Arkos-Engineering/HT-15/hardware/Battery/Radio Interface/Radio Interface.step

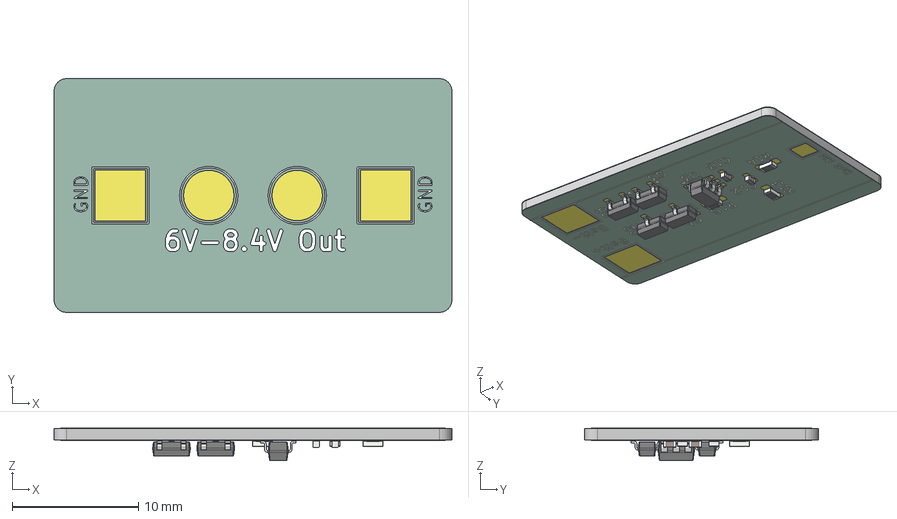
[picture p1: CAD file, 2025-10-05]
hardware/Battery/Radio Interface/Radio Interface.step
31.5 x 18.5 x 2.62 mm
SOT-23-6
R_0603_1608Metric x 3
C_0402_1005Metric x 2
SOT-23 x 4
Radio Interface_copper
Radio Interface_silkscreen
Radio Interface_soldermask
Radio Interface_PCB
