Arkos-Engineering/HT-15/hardware/Implementation/ELECTRICAL SCHEME RT90 & MD9600.pdf

# FM AF PROCESS CIRCUIT

2

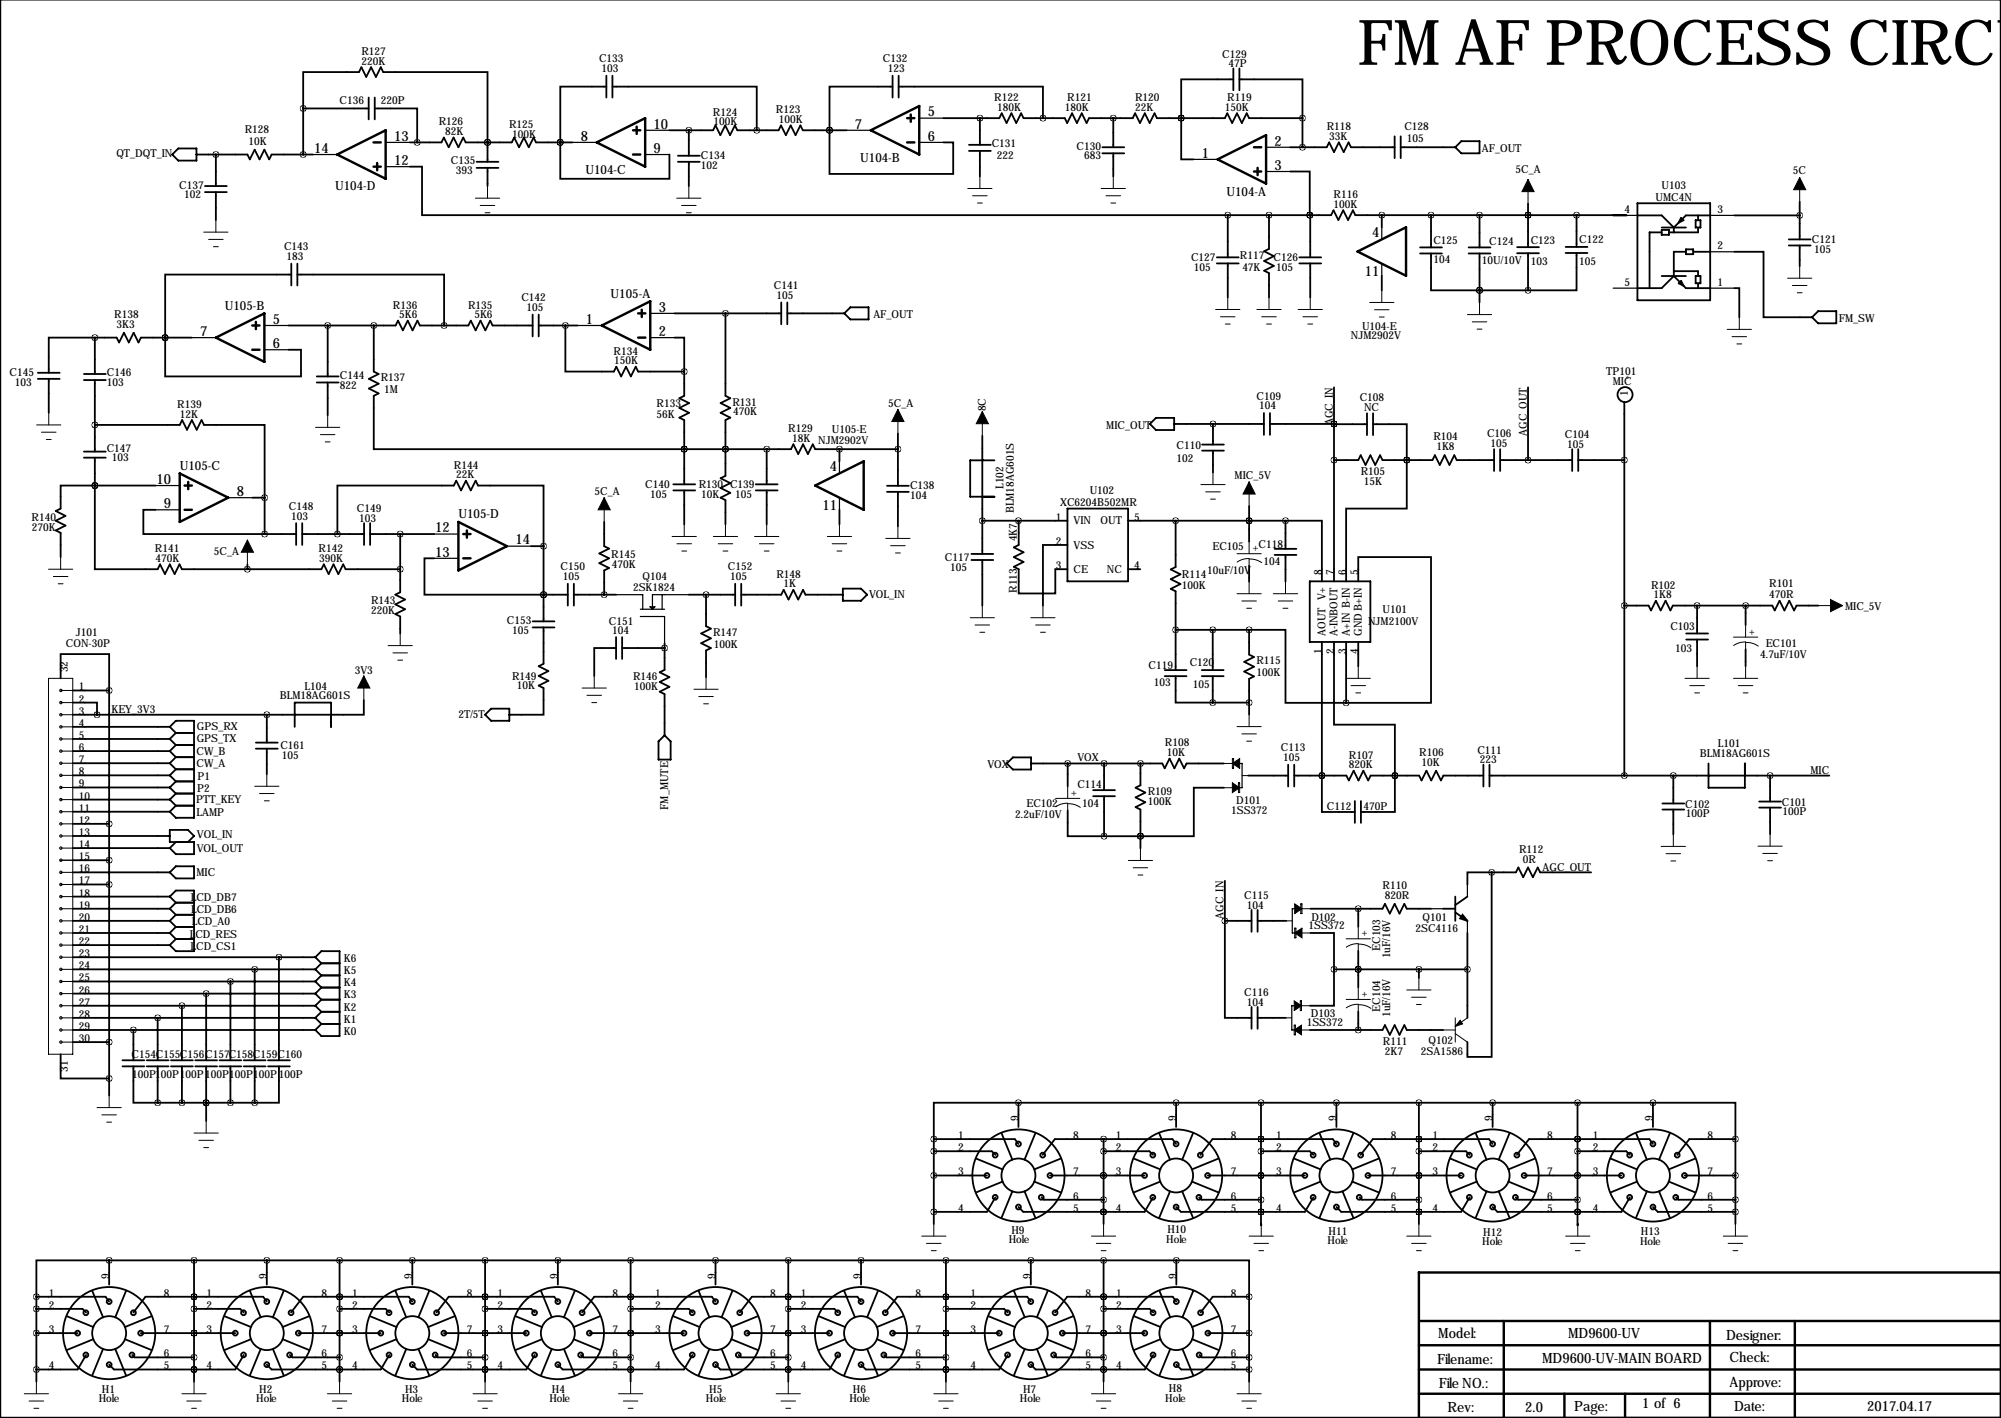
[picture p2: page 1]

Model: | MD9600-UV | Designer:

Filename: | MD9600-UV-MAIN BOARD | Check:

File NO.: | | Approve:
Rev: | 2.0 | Page: | of | Date: | 2017.04.17

# BASEBAND&AF AMP

0603

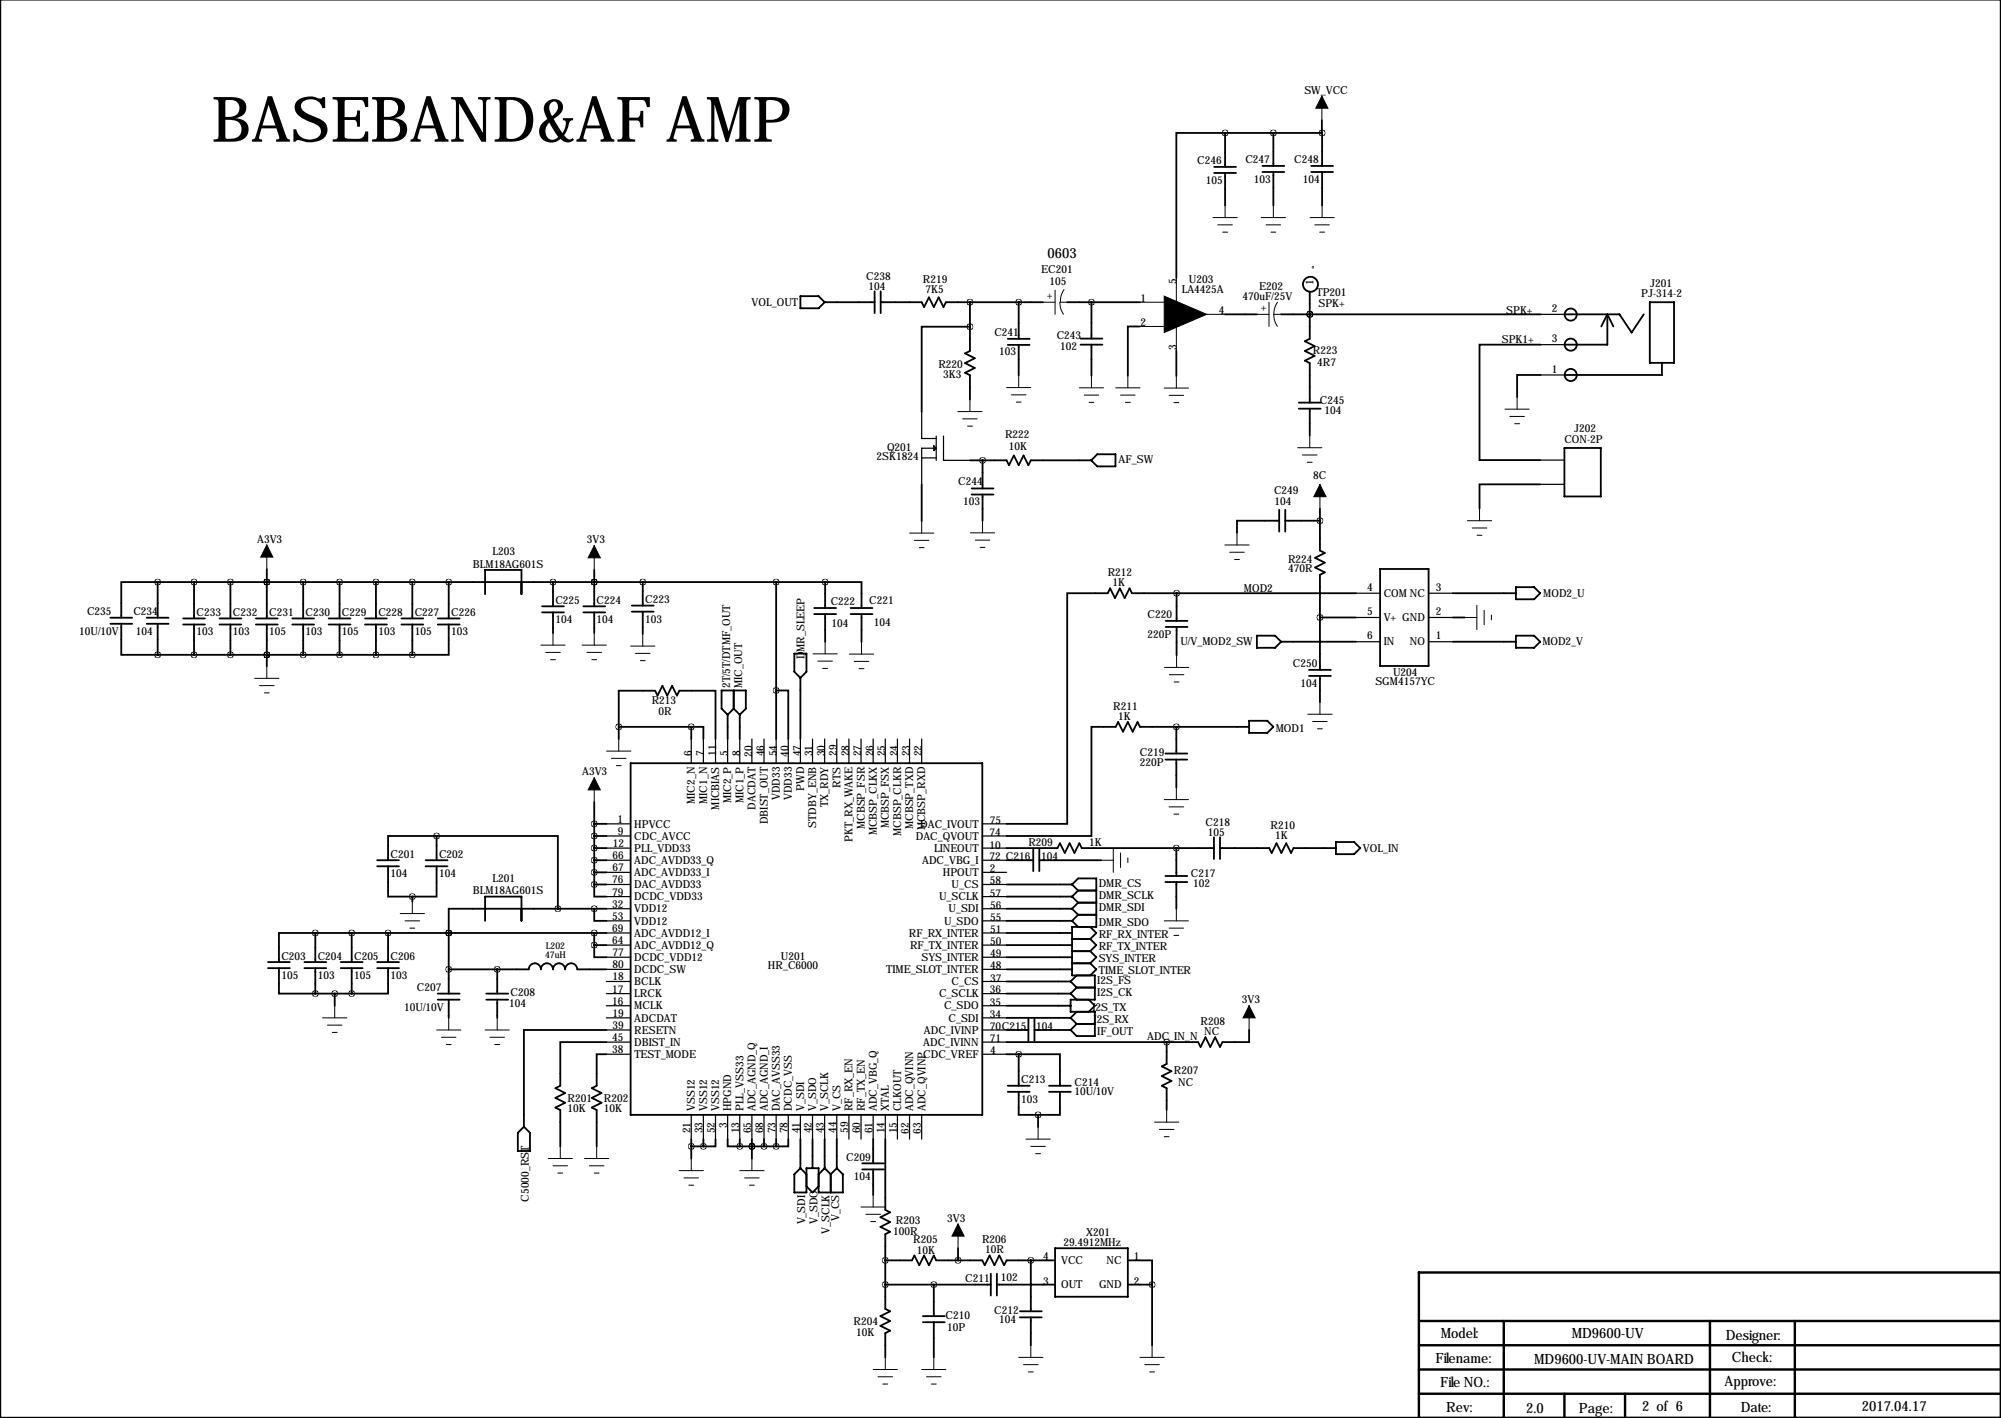
[picture p3: page 2]

# MCU

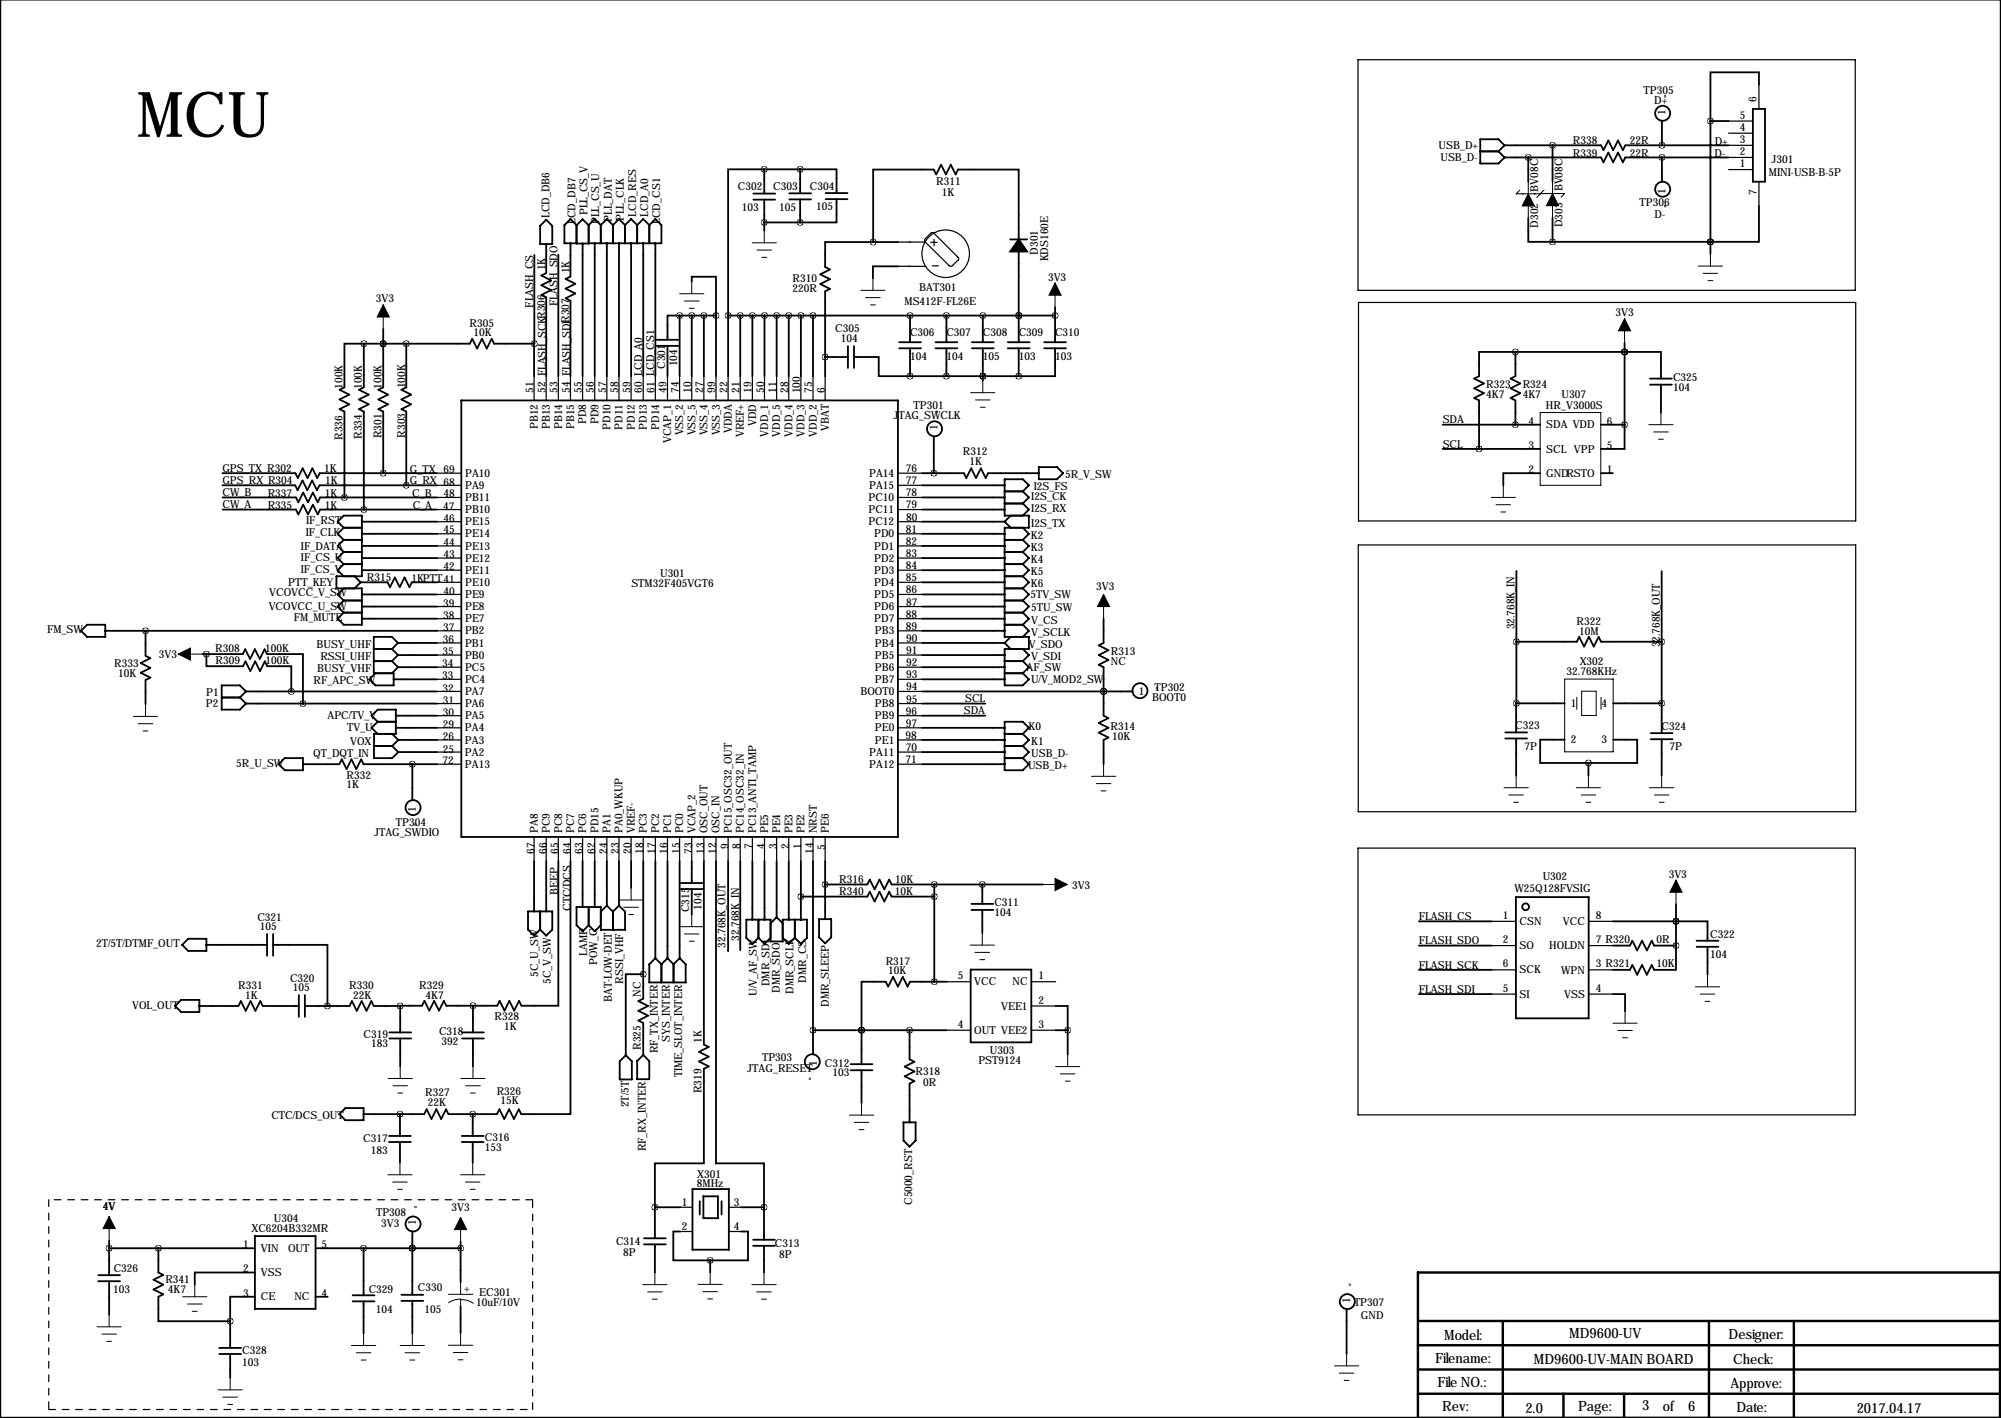
[picture p4: page 3]

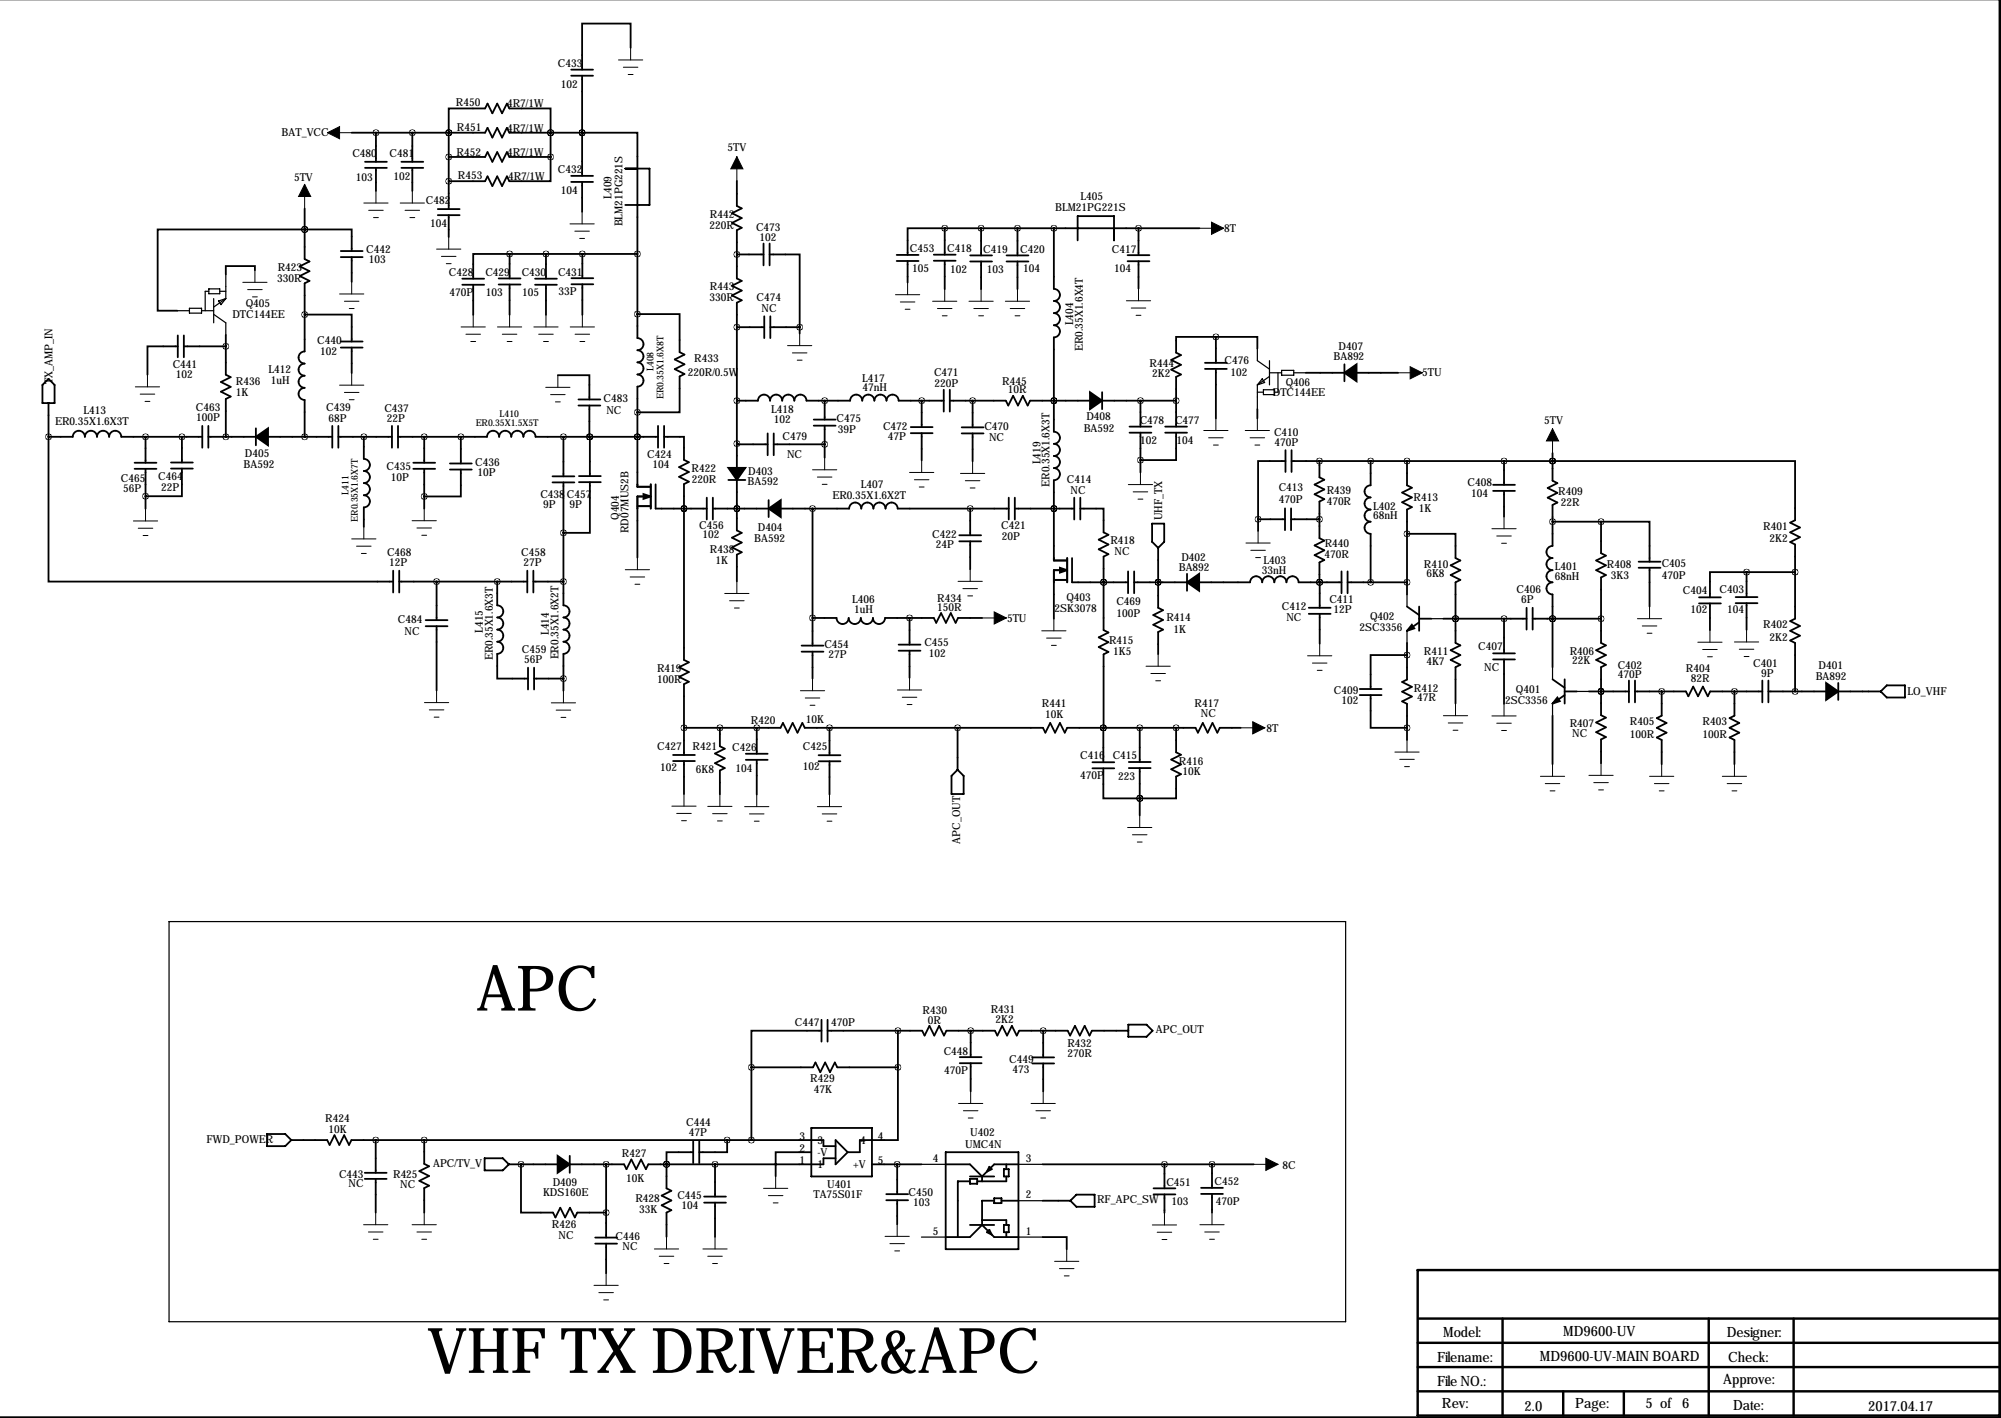
[picture p5: page 4]

0.5W

C560

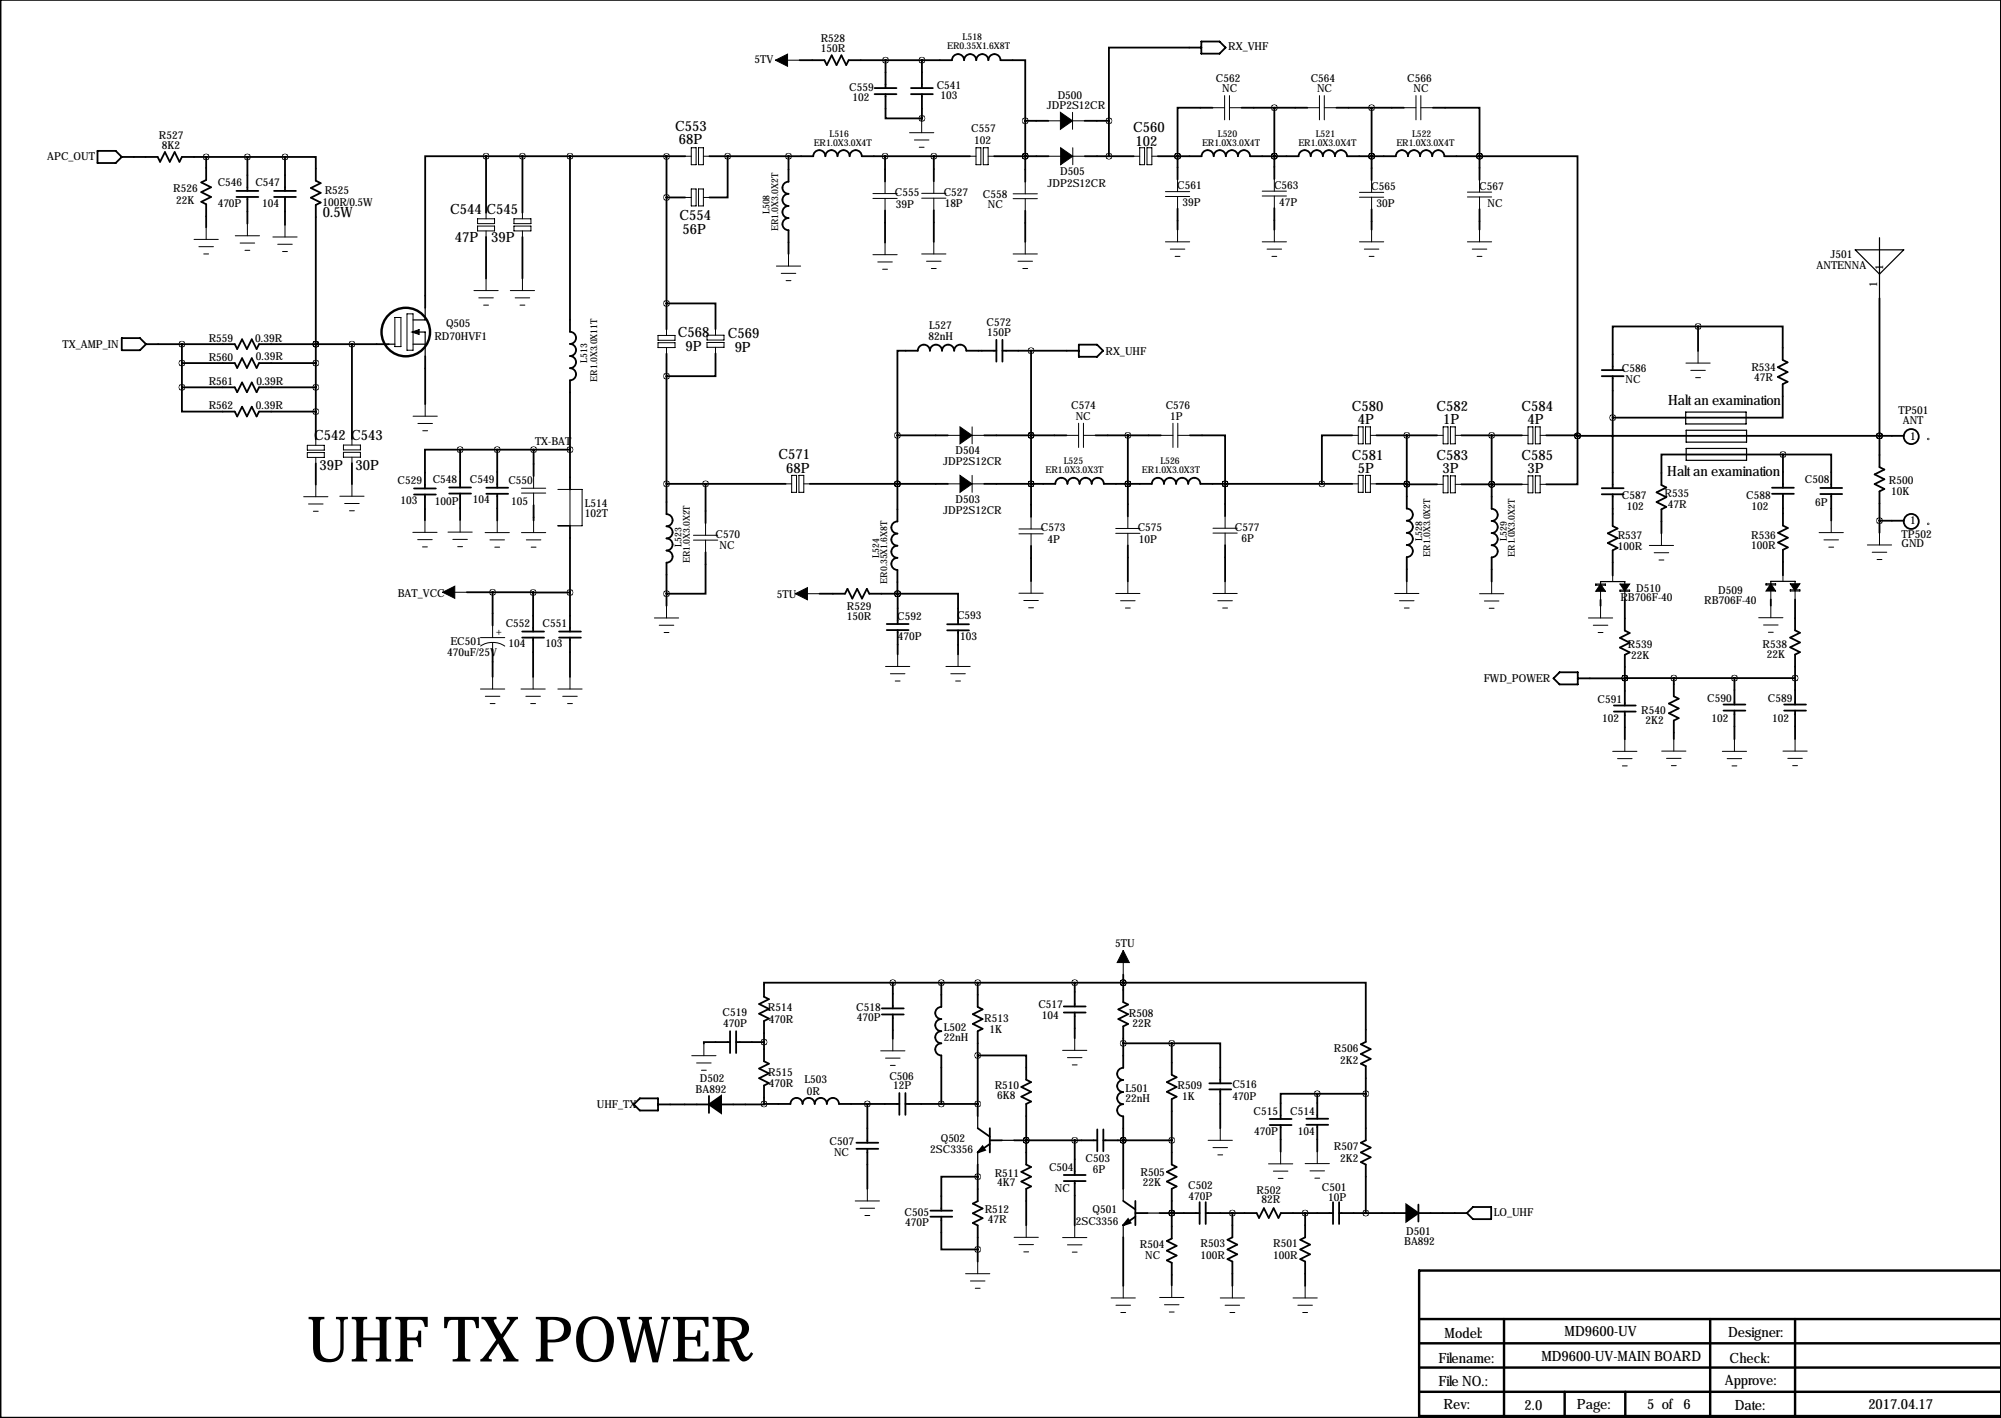
[picture p6: page 5]

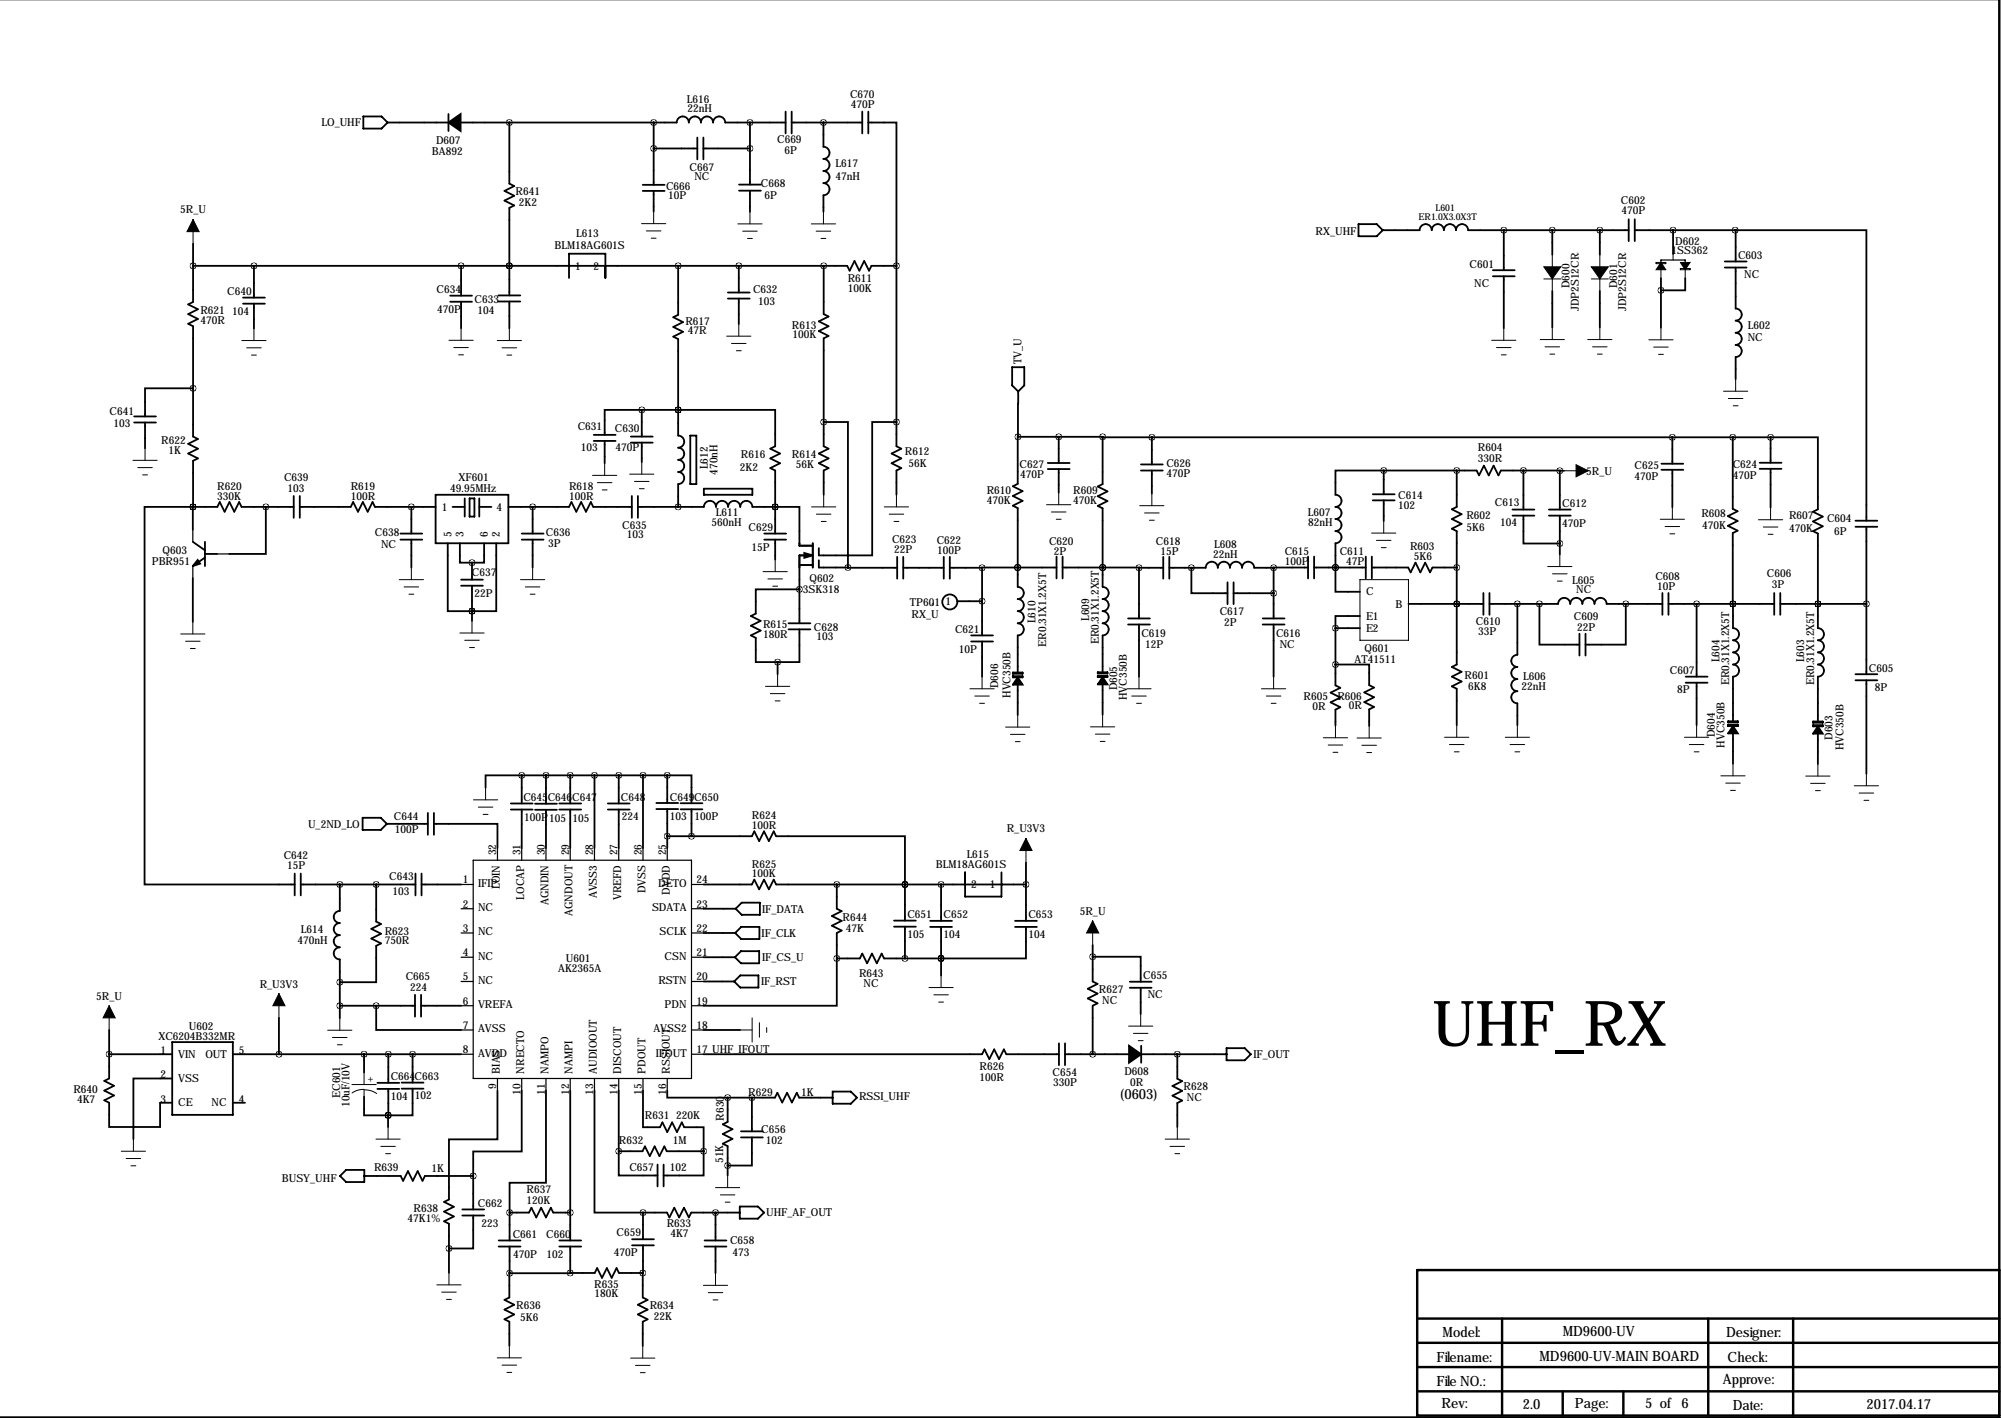
[picture p7: page 6]

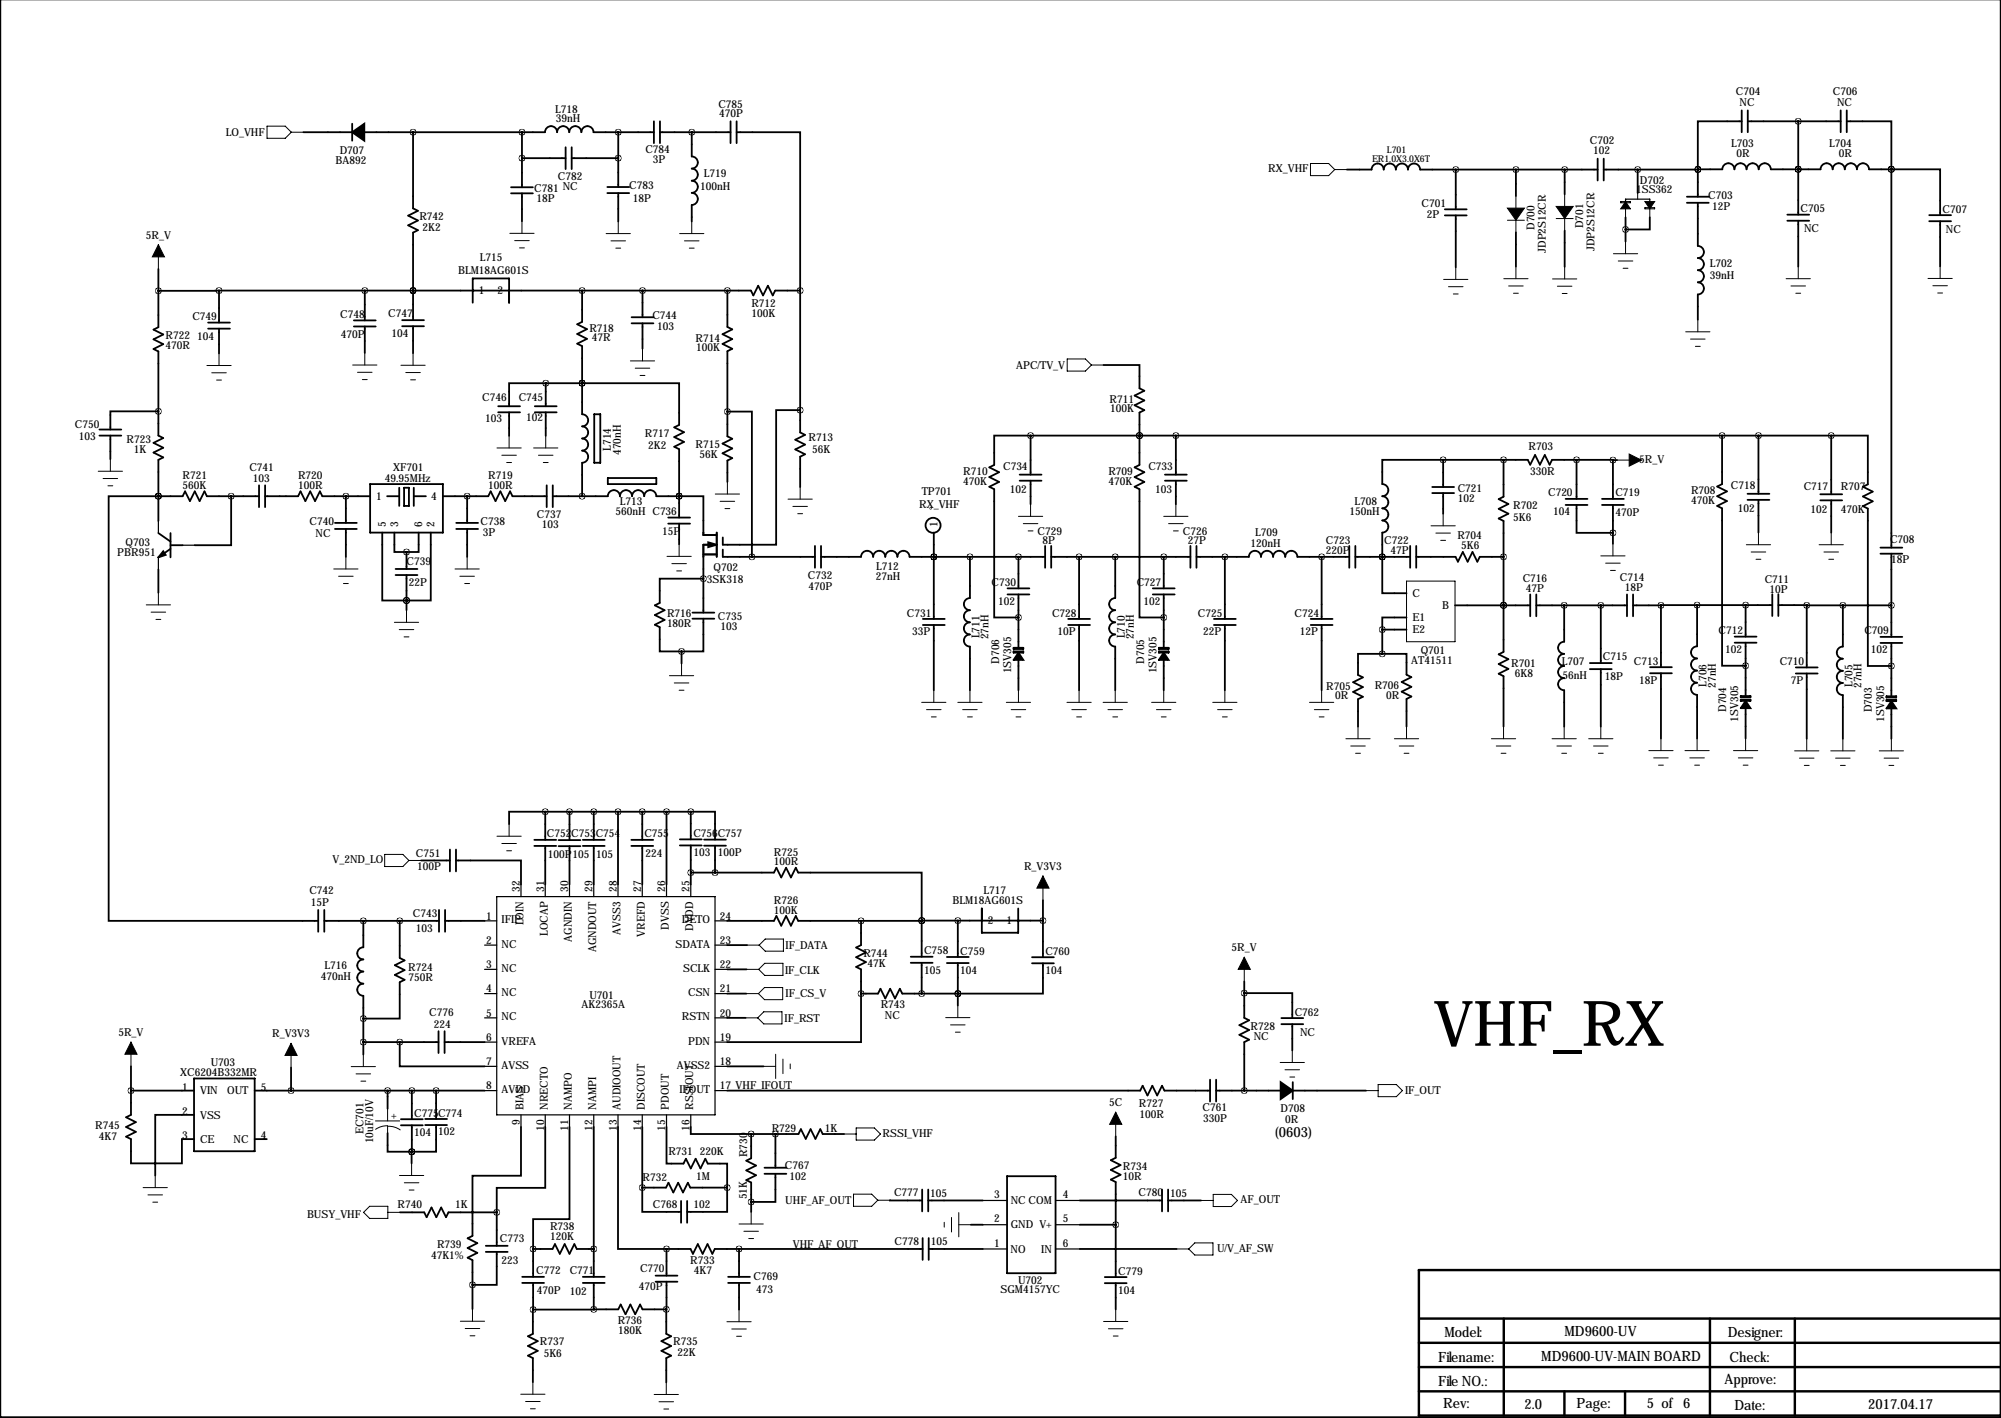
[picture p8: page 7]

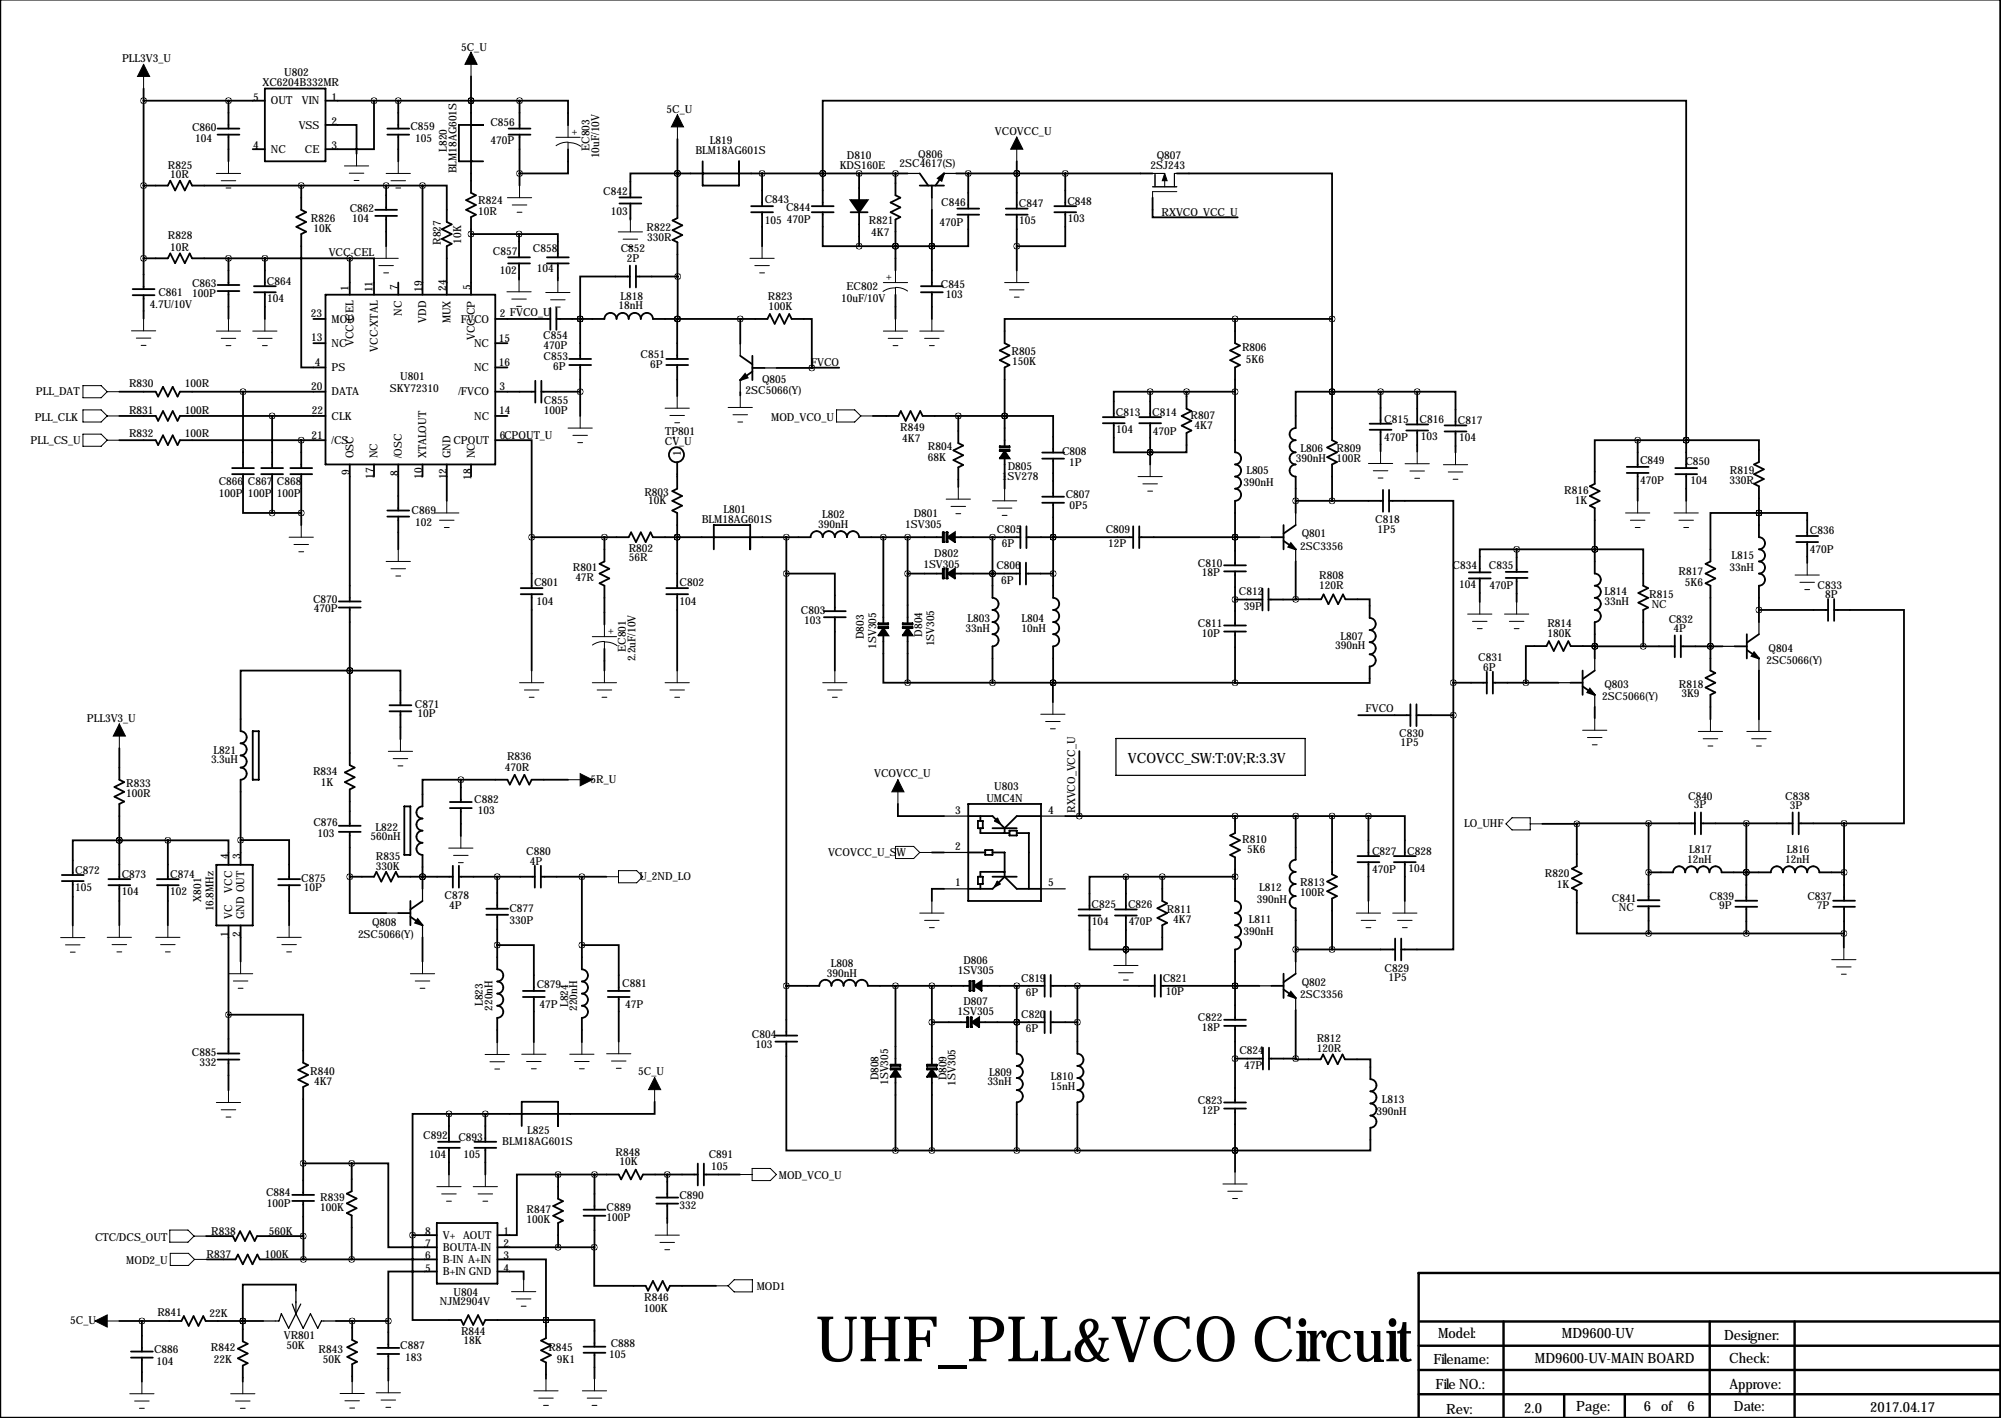
[picture p9: page 8]

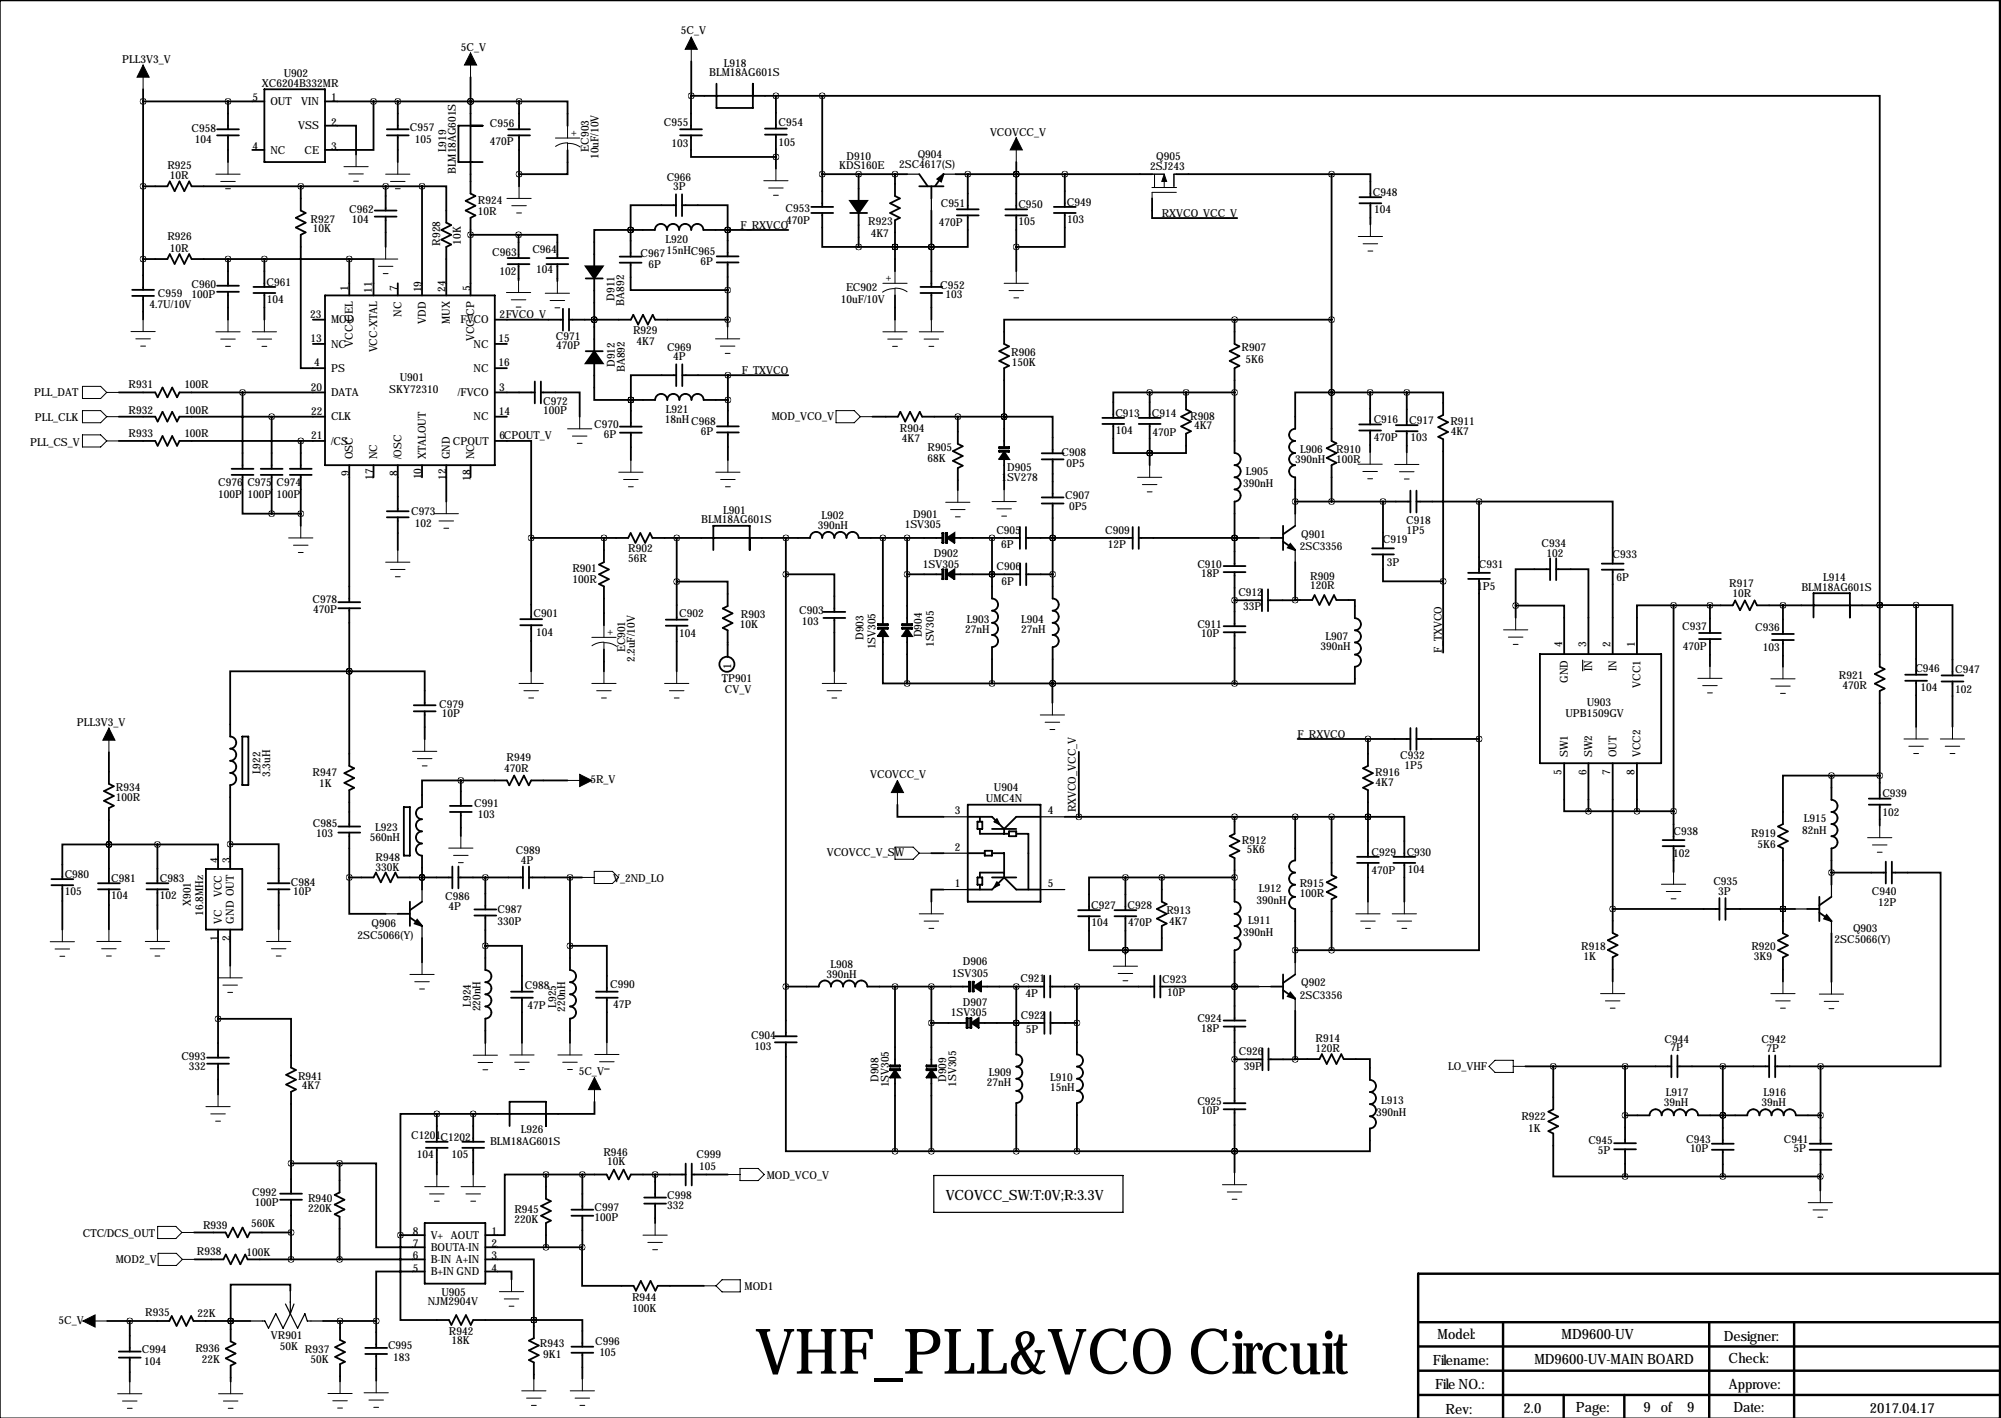
[picture p10: page 9]

# POWER CIRCUT

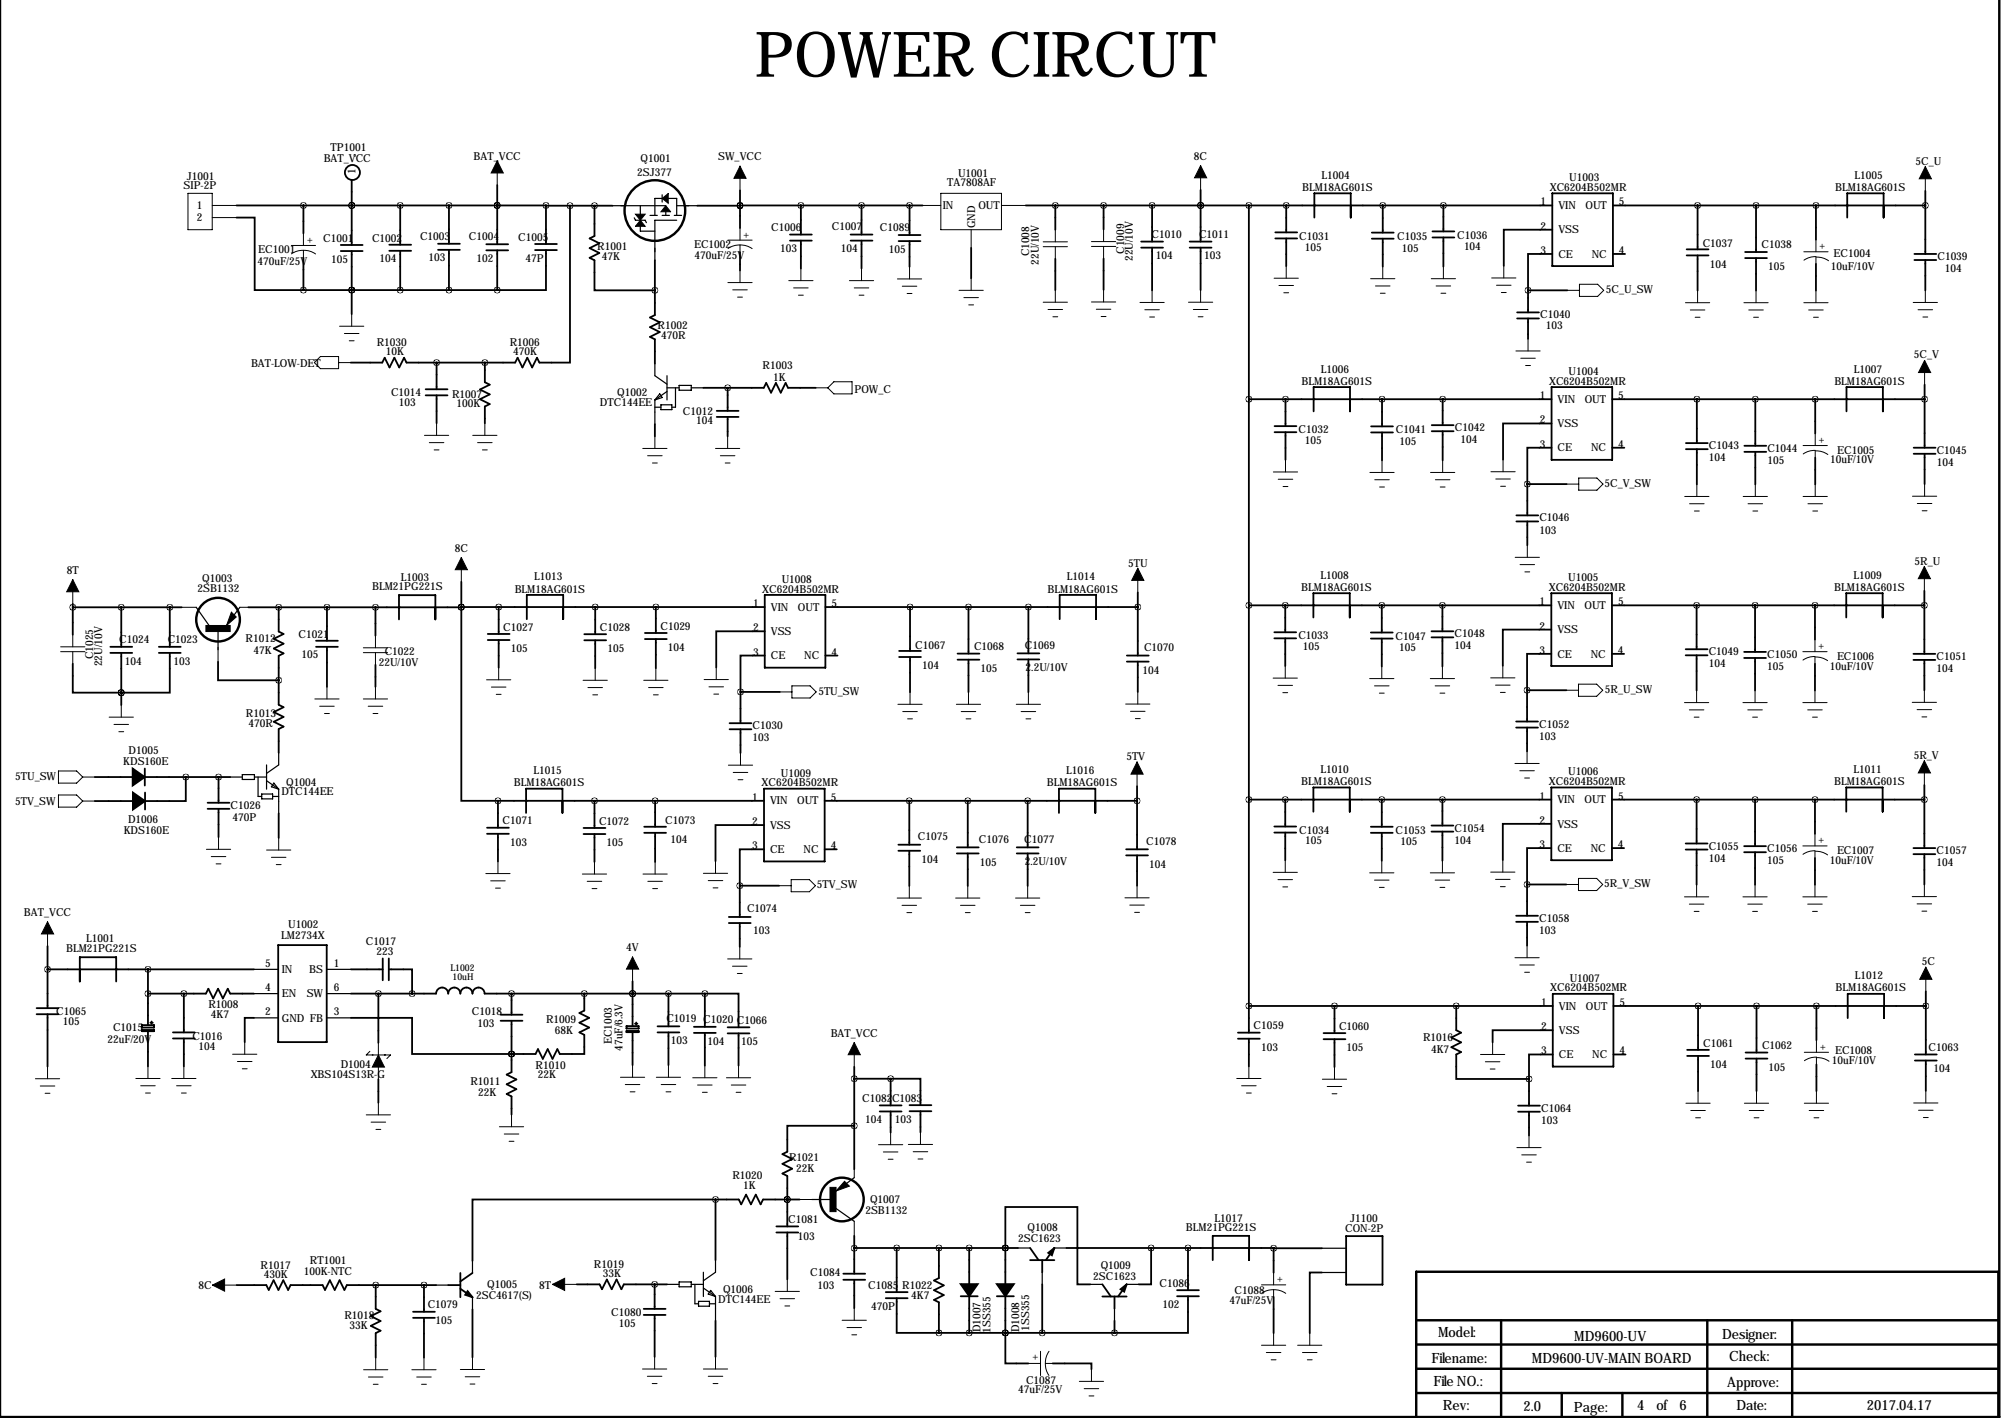
[picture p11: page 10]
