Arkos-Engineering/HT-15/hardware/Implementation/SI4468.pdf

## RF Section

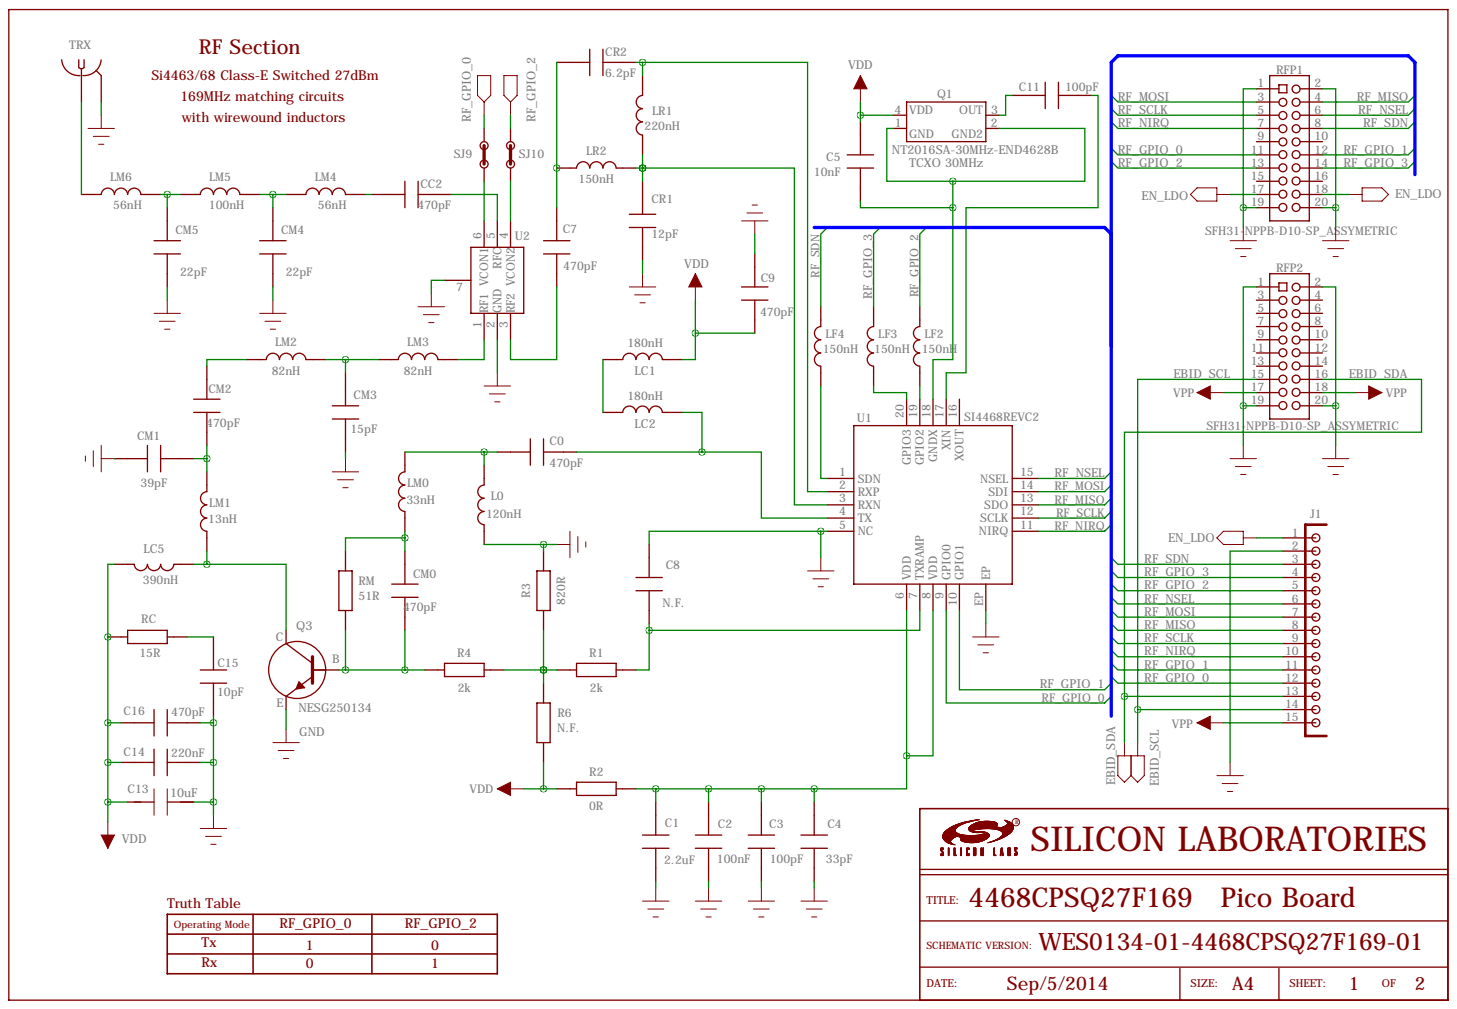
[picture p20: page 1]

Operating Mode | RF_GPIO_0 | RF_GPIO_2
Tx | 1 | 0
Rx | 0 | 1

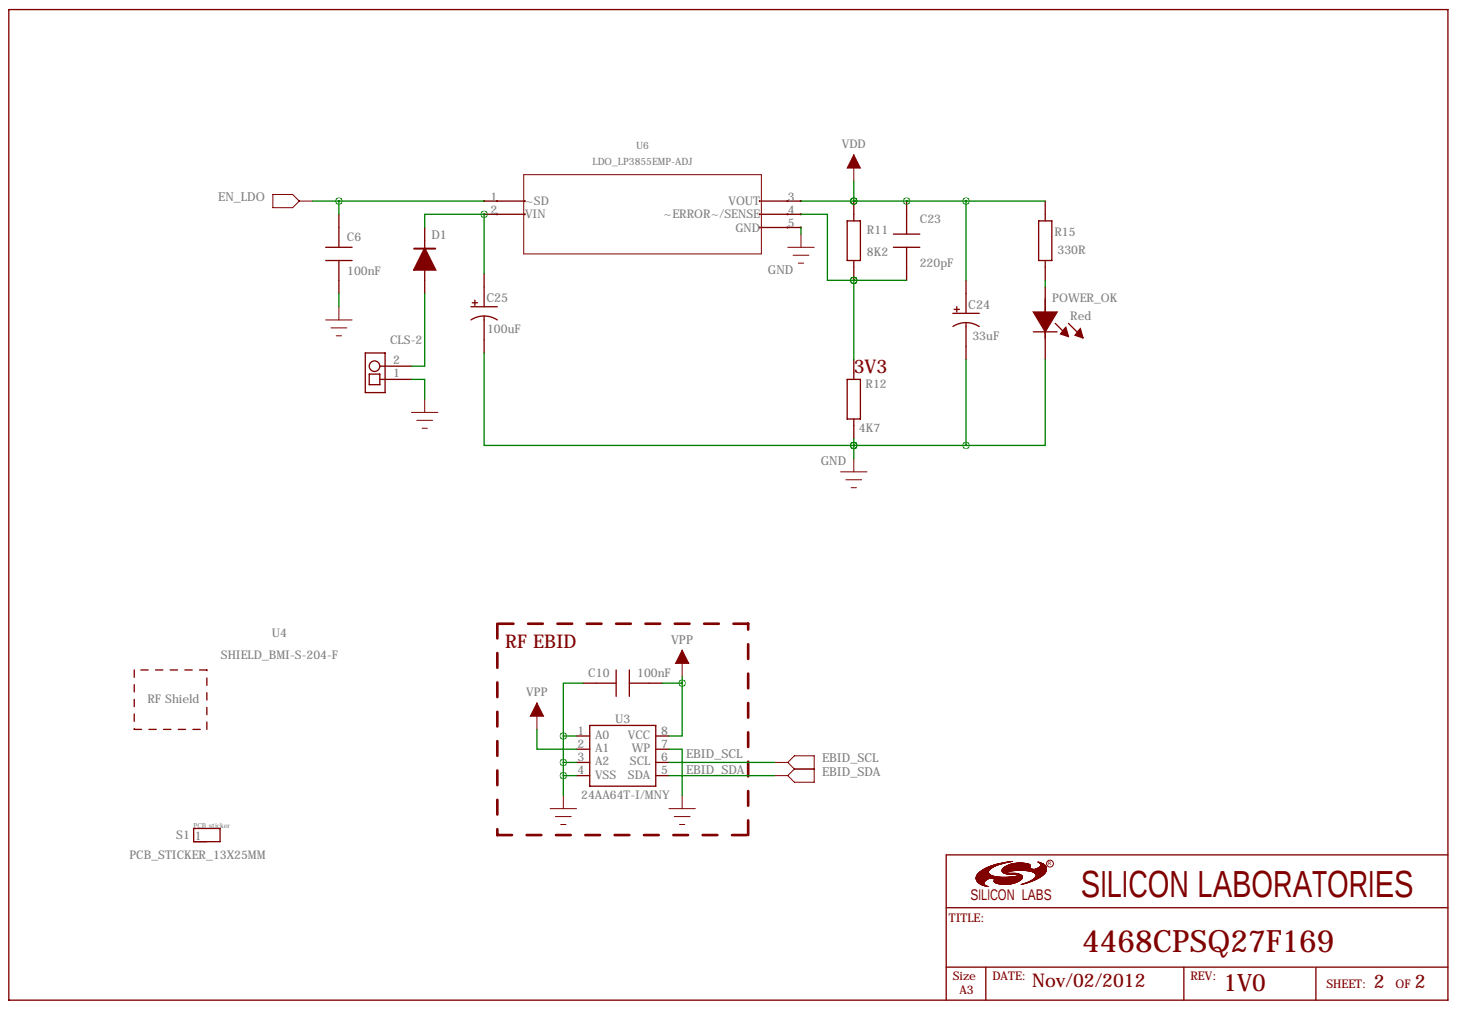
[picture p21: page 2]
