Arkos-Engineering/HT-15/hardware/KiCad Radio Board 2M70CM/Exports/2M70CM_Rev_0.3/Schematic_2M70CM_Rev_0.3.pdf

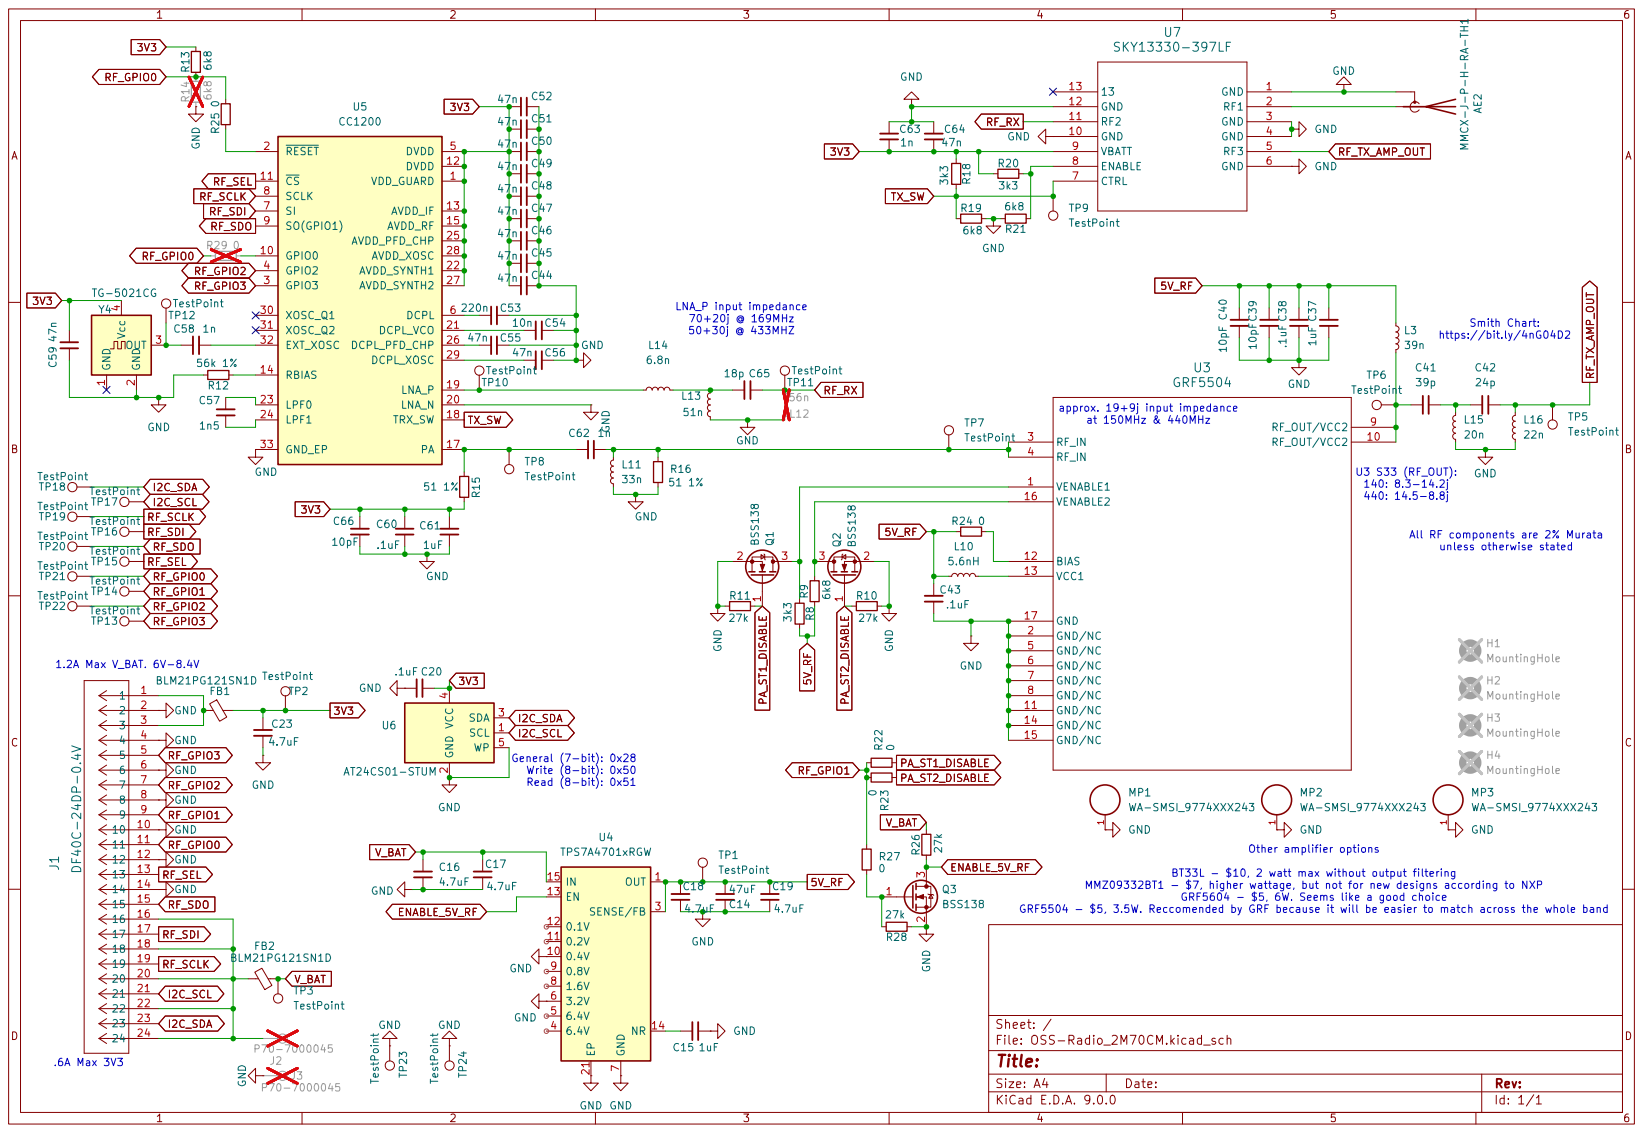
[picture p22: page 1]
