Arkos-Engineering/HT-15/hardware/LTSpice Drawings/Draft1.asc

C1: cap; 100µF
C2: cap; 100µF
M1: nmos; AFT09MS007N
R1: res; 50R
R2: res; 200
R3: res; 50
R4: res; 11
R5: res; 3
V2: voltage; 48V
V3: voltage; SINE(0 3.1 440meg); AC 1; Rser=50
Named nets: 0
.tran 0 .0000001 0 .0000000001
.model AFT09MS007N VDMOS(Rg=0.1 Rd=0.0545 Rs=0.0545 Vto=2.1 Kp=16 Lambda=0 Cgdmax=5p Cgdmin=2.7p Cgs=104.3p Cjo=53.3p M=0.5 Vj=0.7)
.ac oct 10 100meg 1000meg
