Arkos-Engineering/HT-15/hardware/LTSpice Drawings/MOSFET RF front end amplifier.asc

C1: cap; 100µF
C2: cap; 10pF
C3: cap; 27pF
C4: cap; 27pF
C5: cap; 15pF
L1: ind; 39nH
L2: ind; 33nH
L3: ind; 18nH
L4: ind; 18nH
M1: nmos; AFT09MS007N
R1: res; 50R
R2: res; 50
V1: voltage; 2.4
V2: voltage; 60
V3: voltage; SINE(0 .05 140meg); AC 1; Rser=0
Named nets: 0
.tran 0 .0000001 0 .0000000001
.model AFT09MS007N VDMOS(Rg=0.1 Rd=0.0545 Rs=0.0545 Vto=2.1 Kp=16 Lambda=0 Cgdmax=5p Cgdmin=2.7p Cgs=104.3p Cjo=53.3p M=0.5 Vj=0.7)
.ac oct 1000 60meg 700meg
.tran 0 1 0 startup
