Arkos-Engineering/HT-15/hardware/LTSpice Drawings/RF front end amplifier.asc

C1: cap; 100µF
C2: cap; 10pF
Q1: npn; 2SC3356
R1: res; 50R
R2: res; 50
R3: res; 1.225
R4: res; 40
R5: res; 1270
V1: voltage; SINE(0 .05 440000000); AC 1
V2: voltage; 48V
Named nets: 0
.tran 0 .00000009 .00000008 .00000000001
.ac oct 10 1 1G
.model 2SC3356 NPN(IS=6E-16 NF=0.98 ISE=32E-16 NE=1.93 BF=120 IKF=0.17 VAF=10 NR=0.991 ISC=0 NC=2 BR=12 IKR=0.17 VAR=3.9 RB=4.16 IRB=1.96E-04 RBM=3.6 RE=0.38 RC=2  XTB=0 EG=1.11 XTI=3 CJE=2.8E-12 VJE=1.3 MJE=0.5 TF=15E-12 XTF=6 VTF=10 ITF=0.2 PTF=0 CJC=1.1E-12 VJC=0.7 XCJC=0.3 TR=1E-09 CJS=0 VJS=0.75 MJS=0 FC=0.5 Vceo=12 Icrating=100m mfg=cel)
