Arkos-Engineering/HT-15/firmware/HT-15_Test/pindefs.c

enum Pindefs{
    BTN_MTX_A=0,
    BTN_MTX_B=1,
    BTN_MTX_C=2,
    BTN_MTX_D=3,
    BTN_MTX_0=4,
    BTN_MTX_1=5,
    BTN_MTX_2=6,
    BTN_MTX_3=7,
    BTN_MTX_4=8,
    BTN_MTX_5=9,
    SPI1_CLK=10,
    SPI1_SDI=11,
    SPI1_SDO=12,
    AUDIOAMP_MASTERCLK=13,
    AUDIOAMP_SDI=14,
    AUDIOAMP_SCL=15,
    AUDIOAMP_WORDSELECT=16,
    AUDIOAMP_SDO=17,
    SD_CS=18,
    SD_CARD_DETECT=19,
    FLASH_CS=20,
    DISPLAY_CS=21,
    DISPLAY_BUSY=22,
    DISPLAY_RESET=23,
    CHGR_STAT=24,
    AUDIOAMP_POWER=25,
    MARS=26,
    LED_STATUS=27,
    MIC_SCL=28,
    MIC_SDO=29,
    MIC_WORDSELECT=30,
    BTN_ENC_A=31,
    BTN_ENC_B=32,
    RF_GPIO2=33,
    RF_GPIO1=34,
    RF_GPIO0=35,
    RF_SDO=36,
    RF_SEL=37,
    RF_SCLK=38,
    RF_SDI=39,
    RF_GPIO3=40,
    HEADSET_PTT=41,
    I2C1_SDA=42,
    I2C1_SCL=43,
    HEADSET_CONN=44,
    POT_VOLUME=45,
    CHGR_CONN=46,
    V_BAT=47
};
