Arkos-Engineering/HT-15/(commit log)

2025-03-13 experimented with power amplifier circuitry
2025-03-17 added BMS, working on charging IC
2025-03-24 added kicad hardware design directory
    [OSS Radio Hardware Design.kicad_pcb, OSS Radio Hardware Design.kicad_sch]
2025-03-24 need an RF switch
2025-03-24 merged power amp work forgotten on friday
2025-03-27 Working on schematic. MCU done
    [OSS Radio Hardware Design.kicad_sch]
2025-03-28 working on RF chip
    [OSS Radio Hardware Design.kicad_sch]
2025-03-28 added RF IC to schematic (except for power amp)
    [MCU.kicad_sch, OSS Radio Hardware Design.kicad_sch, RF.kicad_sch]
2025-03-28 added 0 ohm resistor swap between v_bat and usb for MCU
    [MCU.kicad_sch]
2025-03-31 working on display connector
    [Display.kicad_sch, OSS Radio Hardware Design.kicad_sch]
2025-04-01 schematic for sd card, external flash, working on audio amp
    [Audio.kicad_sch, Display.kicad_sch, MCU.kicad_sch, OSS Radio Hardware Design.kicad_sch, RF.kicad_sch, Storage.kicad_sch]
2025-04-02 finished schematic for audio
    [Audio.kicad_sch, MCU.kicad_sch, OSS Radio Hardware Design.kicad_sch, Storage.kicad_sch]
2025-04-02 working on battery circuitry
    [MCU.kicad_sch, OSS Radio Hardware Design.kicad_sch, Power.kicad_sch]
2025-04-03 BOM consolidation
    [Audio.kicad_sch, MCU.kicad_sch, Power.kicad_sch, RF.kicad_sch, Storage.kicad_sch]
2025-04-03 working on battery protection and charge
    [Display.kicad_sch, MCU.kicad_sch, Power.kicad_sch]
2025-04-04 finished battery and charger. Now all i need is RF output stages, GPS, and Buttons
    [Display.kicad_sch, Power.kicad_sch, Storage.kicad_sch]
2025-04-07 probably going to change over to PDM for audio out with an opamp
    [Audio.kicad_sch, Buttons.kicad_sch, MCU.kicad_sch, OSS Radio Hardware Design.kicad_sch, Power.kicad_sch]
2025-04-09 added new power supply for audio, working on new audio amp
    [Audio.kicad_sch, MCU.kicad_sch, Power.kicad_sch]
2025-04-09 mostly implemented new audio amp
    [Audio.kicad_sch, MCU.kicad_sch]
2025-04-15 finished audio and encoder
    [Audio.kicad_sch, Buttons.kicad_sch, MCU.kicad_sch]
2025-04-16 throwout Si4468, CC1120 is my friend now. FM has better support apparently
    [MCU.kicad_sch, RF.kicad_sch]
2025-04-17 added ESD diodes, MARS resistor, Charge LED, Status LED
    [Audio.kicad_sch, Buttons.kicad_sch, MCU.kicad_sch, Power.kicad_sch, RF.kicad_sch, Storage.kicad_sch]
2025-04-17 working on fooprints
    [Audio.kicad_sch, Buttons.kicad_sch, Display.kicad_sch, MCU.kicad_sch, Power.kicad_sch, RF.kicad_sch, Storage.kicad_sch]
2025-04-18 added separate project for the radio board, re-organised hardware folder
    [Audio.kicad_sch, Buttons.kicad_sch, Display.kicad_sch, MCU.kicad_sch, OSS Radio Hardware Design.kicad_pcb, OSS Radio Hardware Design.kicad_sch, OSS-Radio_2M70CM.kicad_pcb, OSS-Radio_2M70CM.kicad_sch]
2025-04-19 added connector for RF daughter board
    [Display.kicad_sch, MCU.kicad_sch, RF.kicad_sch]
2025-04-23 working on PCB
    [Audio.kicad_sch, Buttons.kicad_sch, Display.kicad_sch, OSS Radio Hardware Design.kicad_pcb, Power.kicad_sch, RF.kicad_sch, Storage.kicad_sch]
2025-04-24 all GPIO nets connected on schematic
    [Audio.kicad_sch, Buttons.kicad_sch, MCU.kicad_sch, OSS Radio Hardware Design.kicad_pcb, Power.kicad_sch, RF.kicad_sch]
2025-04-26 mostly designed PCB
    [Audio.kicad_sch, Buttons.kicad_sch, Display.kicad_sch, OSS Radio Hardware Design.kicad_pcb, Power.kicad_sch, RF.kicad_sch]
2025-04-26 added schematic pdf
2025-05-02 did all the things
    [MCU.kicad_sch, OSS Radio Hardware Design.kicad_pcb, Power.kicad_sch, Radio Interface.kicad_pcb, Radio Interface.kicad_sch, Radio Interface.step]
2025-05-07 changing board outline
    [OSS Radio Hardware Design.kicad_pcb]
2025-05-07 shrunk mounting cutouts
    [OSS Radio Hardware Design.kicad_pcb]
2025-05-07 added gitignore for kicad backups
2025-05-07 removed zip kicad backups
2025-05-22 changed 3V3 regulator from LDO to switching, updated PCB and minor PCB changes
    [OSS Radio Hardware Design.kicad_pcb, Power.kicad_sch]
2025-06-18 routing PCB
    [MCU.kicad_sch, OSS Radio Hardware Design.kicad_pcb]
2025-06-18 more routing
    [OSS Radio Hardware Design.kicad_pcb]
2025-06-19 finished routing, working on DRC
    [Audio.kicad_sch, MCU.kicad_sch, OSS Radio Hardware Design.kicad_pcb]
2025-06-22 added version text and export files
    [OSS Radio Hardware Design.csv, OSS Radio Hardware Design.kicad_pcb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]
2025-06-22 changed charge output 47uF cap to 4.7uF due to size/voltage constraints
    [OSS Radio Hardware Design.csv, OSS Radio Hardware Design.kicad_pcb, Power.kicad_sch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]
2025-06-22 increased smallest via size, working on fixing clearance issues
    [OSS Radio Hardware Design REFERENCE.csv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]
2025-06-23 fixed routing issues caused by larger vias
    [OSS Radio Hardware Design.kicad_pcb]
2025-06-23 added shunt resistors on 1V8 rail to comply with 1117 minimum load
    [OSS Radio Hardware Design BOM.csv, OSS Radio Hardware Design REFERENCE.csv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]
2025-06-27 made audio amp power swichable
    [Audio.kicad_sch, MCU.kicad_sch, OSS Radio Hardware Design.kicad_pcb, Power.kicad_sch]
2025-06-28 finished routing changes for switching audio power
    [Audio.kicad_sch, OSS Radio Hardware Design.kicad_pcb]
2025-07-02 changed some footprints and minor routing changes
    [OSS Radio Hardware Design.kicad_pcb, Power.kicad_sch]
2025-07-06 working on component selection for RF board
    [OSS-Radio_2M70CM.kicad_sch]
2025-07-10 added tentitive output circuitry for RF, working on RF schematic
    [OSS-Radio_2M70CM.kicad_sch]
2025-07-14 more design on the RF module
    [Audio.kicad_sch, OSS-Radio_2M70CM.kicad_sch]
2025-07-15 changed RF output circuitry to not be a direct short circuit
    [OSS-Radio_2M70CM.kicad_sch]
2025-07-16 release for V0.1 Main Board
    [OSS Radio Hardware Design BOM.csv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]
2025-07-18 added notes to aid future RF matching
    [OSS Radio Hardware Design BOM.csv, OSS Radio Hardware Design BOM.xlsx, OSS-Radio_2M70CM.kicad_sch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]
2025-08-08 added Xometry as enclosure manufacturer, allowing us to SLS print for leff than per device
    [OSS-Radio_2M70CM.kicad_sch]
2025-08-19 added some notes for RF amp
    [MCU.kicad_sch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]
2025-08-28 pre-org rename
    [OSS-Radio_2M70CM.kicad_sch]
2025-08-29 changed RF IC to CC1200 for higher data rate, and better narrowband performance. Also integrated GRF5504 3.5W RF amp
    [OSS-Radio_2M70CM.kicad_sch]
2025-09-09 added RF switch and RX signal path
    [OSS-Radio_2M70CM.kicad_sch]
2025-09-16 added ground planes on top and bottom and ground stitching
    [OSS Radio Hardware Design.kicad_pcb]
2025-09-17 push for HW 0.2 release
    [OSS Radio Hardware Design BOM.xlsx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]
2025-09-19 updated schematic PDF
2025-10-05 added test code for devboards
    [Audio.kicad_sch, Buttons.kicad_sch, Display.kicad_sch, MCU.kicad_sch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]
2025-10-05 wrote a quick test firmware and swapped PTT and Side2 buttons
    [Buttons.kicad_sch, OSS Radio Hardware Design.kicad_pcb]
2025-10-07 added battery voltage sampling
2025-10-08 changing charging circuitry because the current regulater is linear
    [MCU.kicad_sch, Power.kicad_sch]
2026-03-19 bom changes and removed extra 51 ohm resistor
    [OSS-Radio_2M70CM.kicad_pcb, OSS-Radio_2M70CM.kicad_sch]
2026-03-19 moved some stuff around
    [OSS-Radio_2M70CM.kicad_pcb]
2026-03-19 V0.3 export
    [OSS-Radio_2M70CM.kicad_pcb]
2026-03-19 RF board for release 0.3
    [OSS-Radio_2M70CM-bom.csv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]
2026-03-20 changed C57 part. It was an 0201 instead of an 0402
    [OSS-Radio_2M70CM-bom.csv, OSS-Radio_2M70CM.kicad_sch]
2026-04-22 added implementation guide for cc1200 to datasheets, added PDF schematic for RF module
2026-04-23 moved rev 3 schematic
2026-05-01 fixed connector in mainboard schematic that I moved accidentally
    [Power.kicad_sch]
